DanilVDV/esp32-anenji-wifi-rs485-controller/docs/screenshots.md

# Актуальные скриншоты Web UI

Скриншоты сняты с текущего интерфейса прошивки v0.15.6 по записи экрана от 2026-10-08.

## Обзор / энергетическая схема

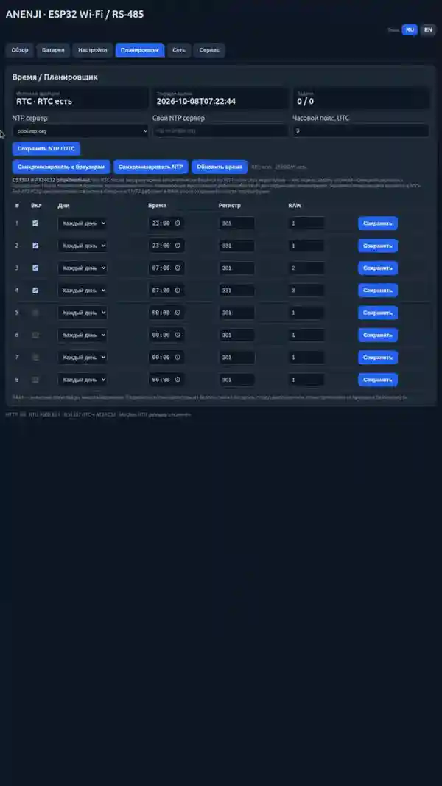
[picture p7: docs/media/dashboard.webp]
Обзор


## Статистика аккумулятора

Статистика аккумулятора

## Время / Планировщик

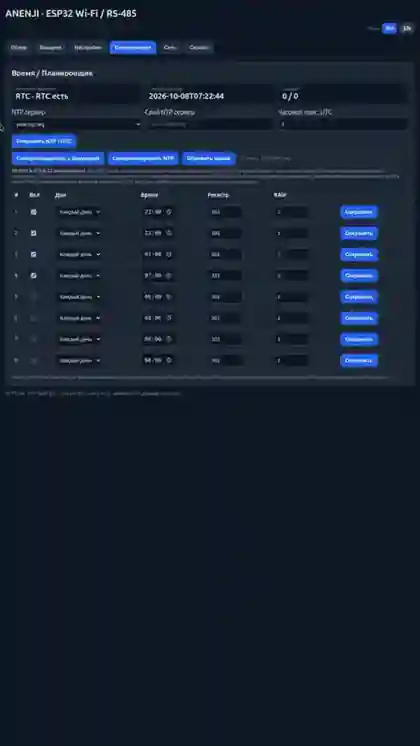
[picture p8: docs/media/rtc-scheduler.webp]
Время и планировщик


## Wi-Fi / сеть ESP32 и Modbus / RS-485

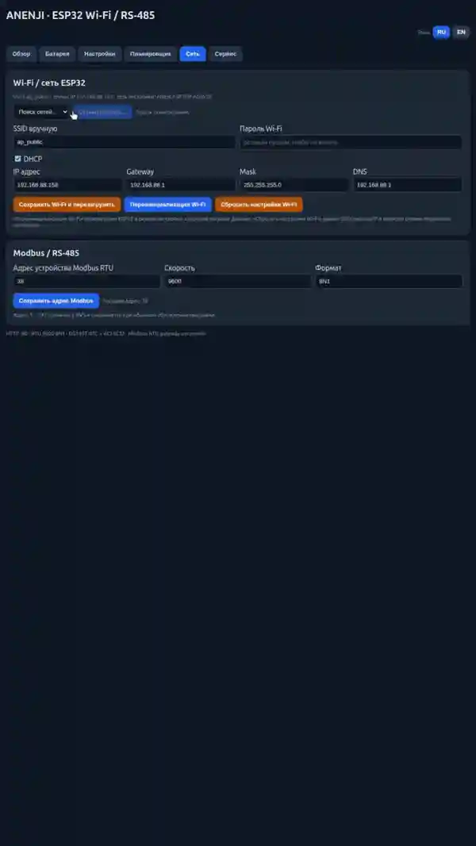
[picture p9: docs/media/network-modbus.webp]
Сеть и Modbus


## Сервис / PZEM-016 / OTA

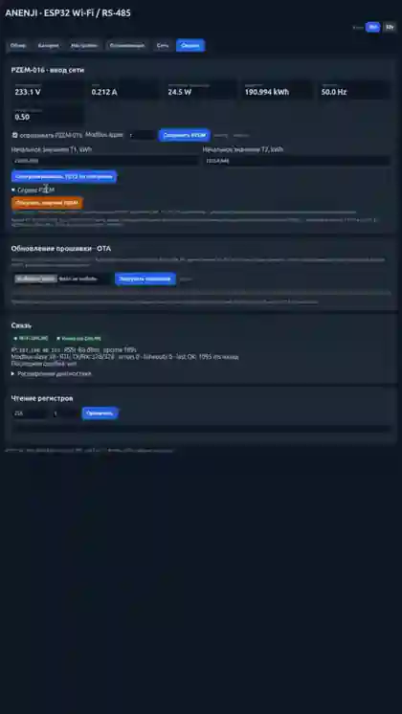
[picture p10: docs/media/service-pzem-ota.webp]
Сервис, PZEM и OTA
