DanilVDV/esp32-anenji-wifi-rs485-controller/docs/registers.md

# Modbus registers and battery profiles

Ниже перечислен allow-list из `SETTINGS[]`. `scale` означает делитель raw-значения для отображаемой величины там, где используется numeric setting.

| Reg | Group | Label | Type | Scale | Allowed |
|---:|---|---|---|---:|---|
| 300 | Основные | AC output mode | select | 1 | 0..4 |
| 301 | Основные | Приоритет выхода | select | 1 | 1..4 |
| 302 | Прочие | Диапазон входного напряжения | select | 1 | 0..2 |
| 303 | Прочие | Зуммер | select | 1 | 0..3 |
| 305 | Прочие | Подсветка LCD | select | 1 | 0..1 |
| 306 | Прочие | Автовозврат LCD | select | 1 | 0..1 |
| 307 | Прочие | Энергосбережение | select | 1 | 0..1 |
| 308 | Прочие | Автоперезапуск после перегрузки | select | 1 | 0..1 |
| 309 | Прочие | Автоперезапуск после перегрева | select | 1 | 0..1 |
| 310 | Прочие | Overload bypass | select | 1 | 0..1 |
| 313 | АКБ | Выравнивание АКБ | select | 1 | 0..1 |
| 320 | Основные | Выходное напряжение | select | 1 | 2200/2300/2400 |
| 321 | Основные | Выходная частота | select | 1 | 5000/6000 |
| 322 | АКБ | Тип АКБ | select | 1 | 0..2 |
| 323 | АКБ | Защита от перенапряжения АКБ | number | 10 | 0..6553.5 |
| 324 | АКБ | Bulk / CV | number | 10 | 0..6553.5 |
| 325 | АКБ | Float | number | 10 | 0..6553.5 |
| 326 | АКБ | Возврат к сети, напряжение | number | 10 | 0..6553.5 |
| 327 | АКБ | Low DC в режиме сети | number | 10 | 0..6553.5 |
| 329 | АКБ | Low DC off-grid | number | 10 | 0..6553.5 |
| 330 | АКБ | CV -> Float, время | number | 1 | 0..600 |
| 331 | АКБ | Приоритет зарядки | select | 1 | 1..4 |
| 332 | АКБ | Макс. ток зарядки | number | 10 | 0..6553.5 |
| 333 | АКБ | Макс. ток зарядки от сети | number | 10 | 0..6553.5 |
| 334 | АКБ | Напряжение equalization | number | 10 | 0..6553.5 |
| 335 | АКБ | Equalization time | number | 1 | 0..180 |
| 336 | АКБ | Equalization timeout | number | 1 | 0..300 |
| 337 | АКБ | Equalization interval | number | 1 | 1..90 |
| 341 | SOC | Low DC SOC в режиме сети | number | 1 | 0..100 |
| 342 | SOC | Recovery SOC | number | 1 | 0..100 |
| 343 | SOC | Off-grid cut-off SOC | number | 1 | 0..100 |
| 344 | Основные | Макс. отдача в сеть | number | 1 | 0..6200 |
| 351 | АКБ | Макс. ток разряда АКБ | number | 1 | 0..65535 |
| 406 | Remote | Turn-on mode | select | 1 | 0..2 |

## Профили

Raw values в точности из исходника.

### `ANJ_24V_8S_1P`

```text
313=0, 322=2, 332=150, 333=100,
324=280, 325=272, 327=232, 329=220,
341=20, 342=30, 343=15, 351=80
```

### `ANJ_24V_8S_2P`

```text
313=0, 322=2, 332=150, 333=100,
324=280, 325=272, 327=232, 329=220,
341=20, 342=30, 343=15, 351=120
```

### `ANJ_48V_STANDARD`

```text
313=0, 322=2, 332=100, 333=100,
324=564, 325=540, 327=460, 329=440,
341=20, 342=30, 343=15, 351=95
```

### `ANJ_48V_LONG_LIFE`

```text
313=0, 322=2, 332=100, 333=100,
324=560, 325=540, 327=460, 329=440,
341=20, 342=30, 343=15, 351=80
```

> Эти значения документируют поведение исходной прошивки, а не являются универсальной рекомендацией для любой LiFePO4-системы.
