DanilVDV/esp32-anenji-wifi-rs485-controller/docs/media/battery-stats.png

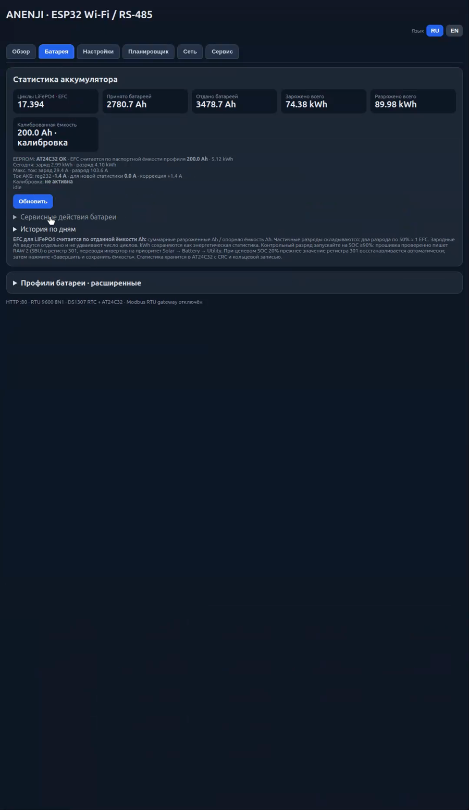
docs/media/battery-stats.png
