DanilVDV/esp32-anenji-wifi-rs485-controller/docs/media/dashboard.png

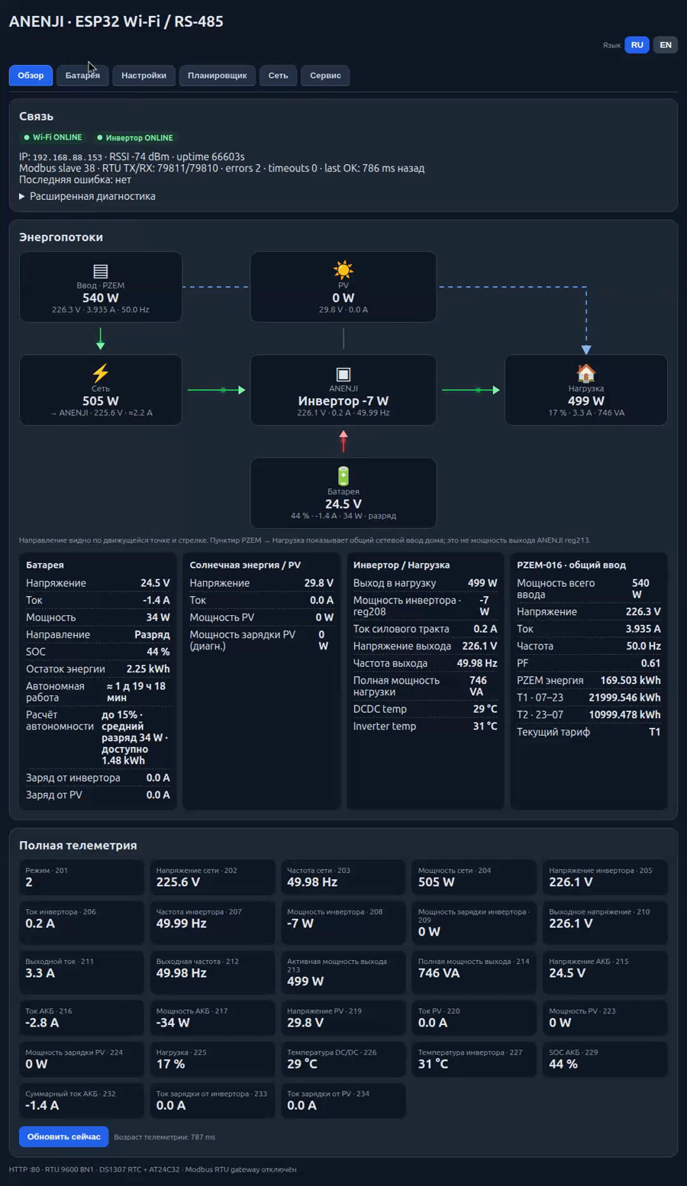
docs/media/dashboard.png
