DanilVDV/esp32-anenji-wifi-rs485-controller/docs/media/network-modbus.png

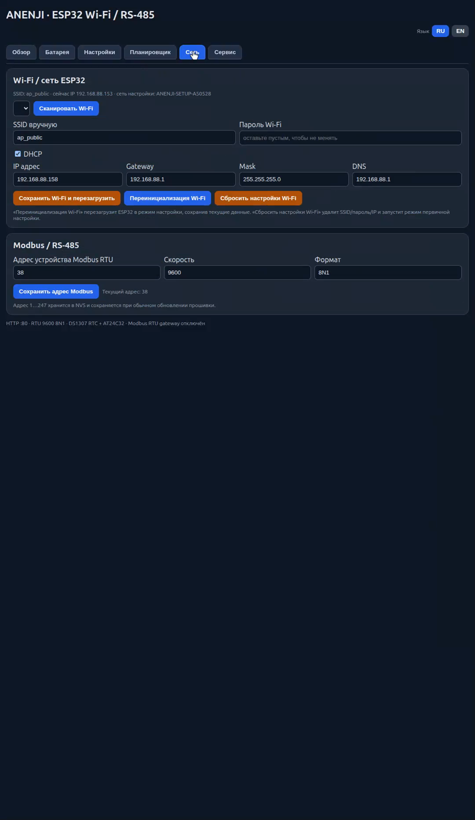
docs/media/network-modbus.png
