DanilVDV/esp32-anenji-wifi-rs485-controller/docs/media/rtc-scheduler.png

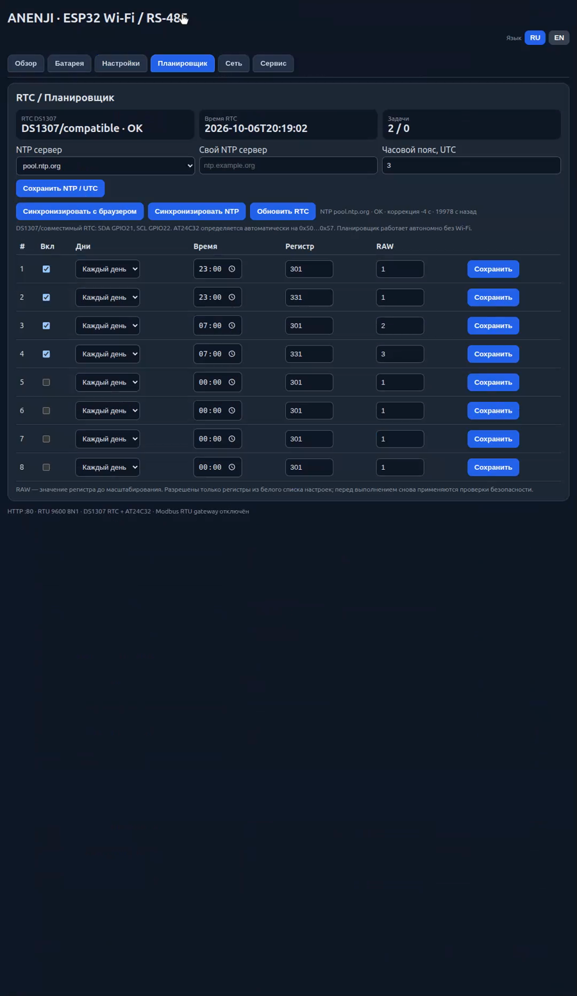
docs/media/rtc-scheduler.png
