DanilVDV/esp32-anenji-wifi-rs485-controller/docs/media/ui-v0157-service-2.png

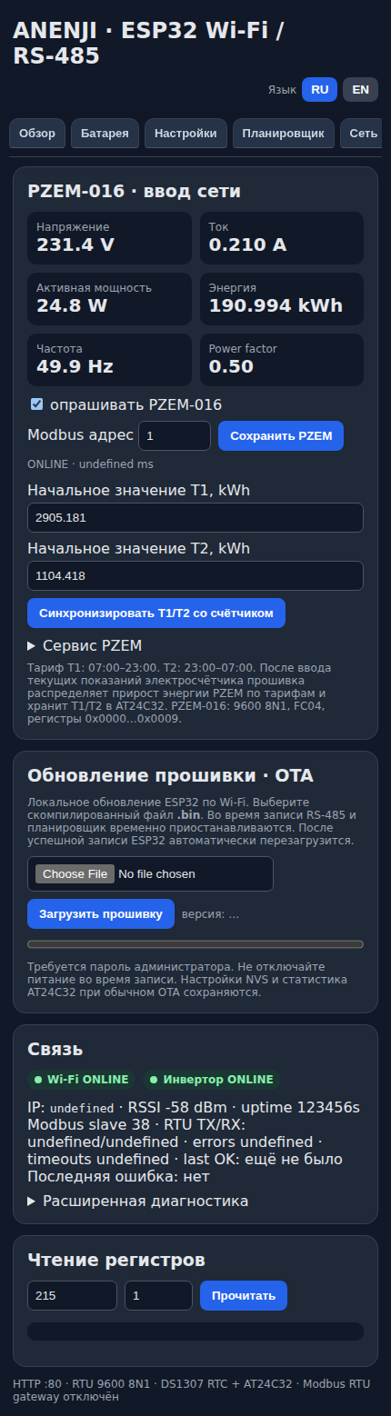
docs/media/ui-v0157-service-2.png
