DanilVDV/esp32-anenji-wifi-rs485-controller/docs/wiring.md

# Wiring / схема подключения

## 1. Подключение к ANENJI через RJ45 — порт RS‑485 (BMS)

Контроллер подключается к инвертору через разъём **RJ45** в гнездо **RS‑485 (BMS)**. Этот порт штатно предназначен для подключения BMS аккумуляторной батареи, однако доступный на нём Modbus RTU позволяет проекту не только читать телеметрию, но и записывать разрешённые параметры инвертора, применять профили и выполнять команды по расписанию.

По предоставленной таблице распиновки порта инвертора:

| Pin RJ45 | Цвет T568B | Сигнал |
|---:|---|---|
| 1 | бело‑оранжевый | **RS485-B** |
| 2 | оранжевый | **RS485-A** |
| 7 | бело‑коричневый | **RS485-A** |
| 8 | коричневый | **RS485-B** |
| 3–6 | остальные жилы | не используются |

Иными словами: **бело‑оранжевый = B, оранжевый = A, бело‑коричневый = A, коричневый = B**.

<p align="center">
  ANENJI RJ45 RS485 pinout
</p>

<p align="center">
  Connection to ANENJI RJ45 RS485 BMS
</p>

> Перед включением прозвоните кабель мультиметром. При взгляде на вилку с разных сторон нумерация RJ45 визуально зеркалится, поэтому ориентируйтесь на фактическую нумерацию контактов и цвета T568B.

## 2. ESP32 ↔ RS‑485 transceiver

Прошивка использует UART2 ESP32. На разных ESP32 DevKit одна и та же ножка может быть подписана как `4`, `IO4`, `D4` и т. п. **Главный ориентир — номер GPIO**; колонка ниже показывает распространённые варианты шелкографии.

| Сигнал | GPIO | Маркировка на ESP32 DevKit (типично) | Куда подключать |
|---|---:|---|---|
| RX2 | **16** | `RX2` / `IO16` / `16` / `D16` | `RO` RS‑485 transceiver |
| TX2 | **17** | `TX2` / `IO17` / `17` / `D17` | `DI` RS‑485 transceiver |
| Direction | **4** | `D4` / `IO4` / `4` | объединённые `DE` и `/RE` |
| 3.3 V | — | **`3V3` / `3.3V`** | `VCC` RS‑485 transceiver |
| GND | — | **`GND`** | общий GND |

Линии `A` и `B` трансивера идут на соответствующие линии RJ45 инвертора. PZEM‑016 может находиться на этой же half‑duplex шине.

```text
ESP32 DevKit                       RS-485 transceiver            RJ45 ANENJI RS-485 (BMS)
------------                       ------------------            ------------------------
GPIO17 / TX2 / IO17 -------------> DI
GPIO16 / RX2 / IO16 <------------- RO
GPIO4 / D4 / IO4 ----------------> DE + /RE
3V3 / 3.3V ----------------------> VCC
GND ------------------------------> GND
                                     A  --------------------------> A: pin 2 / pin 7
                                     B  --------------------------> B: pin 1 / pin 8
```

<p align="center">
  ESP32 DevKit pin labels used by ANENJI controller
</p>

Рекомендации для физического слоя:

- RS‑485-трансивер в этой сборке питается от **3.3 V (`3V3`)**; используйте модуль, рассчитанный на такое питание и логические уровни ESP32;
- общий GND обычно необходим, если нет гальванической развязки;
- используйте витую пару для A/B;
- терминация 120 Ω ставится по правилам конкретной RS‑485 топологии, обычно на концах длинной линии;
- если обмена нет, проверьте адрес Modbus и полярность A/B — маркировка A/B у разных производителей встречается инверсной.

## 3. I²C + ADS1115 + PZCT-DC63-300A

ESP32 использует `GPIO21`/`GPIO22` как общую I²C-шину. RTC и AT24C32 работают от 3.3 V. **ADS1115 и используемый PZCT-DC63-300A питаются от 5 V**, поэтому I²C-линии ADS1115 должны быть согласованы с 3.3-вольтовой логикой ESP32.

| Сигнал ESP32 | GPIO | Маркировка на ESP32 DevKit (типично) | Подключение |
|---|---:|---|---|
| SDA | **21** | `SDA` / `D21` / `IO21` / `21` | SDA RTC / AT24C32; к ADS1115 через I²C level shifter |
| SCL | **22** | `SCL` / `D22` / `IO22` / `22` | SCL RTC / AT24C32; к ADS1115 через I²C level shifter |
| 3.3 V | — | **`3V3` / `3.3V`** | VCC RTC / AT24C32 и LV level shifter |
| 5 V | — | **`5V` / `VIN`** | ADS1115 `VDD`, PZCT-DC63-300A `VCC`, HV level shifter |
| GND | — | **`GND`** | общий GND |

Типовой ADS1115 с выводами `VDD, SCL, SDA, ADDR, ALRT, A0…A3` подключается так:

| ADS1115 | Подключение |
|---|---|
| `VDD` | `5V / VIN` ESP32 |
| `GND` | общий GND |
| `SDA` | к GPIO21 через level shifter |
| `SCL` | к GPIO22 через level shifter |
| `ADDR` | к GND → адрес `0x48` |
| `ALRT` | не подключать |
| `A0` | `OUT` PZCT-DC63-300A |
| `A1…A3` | свободны / могут использоваться вместо A0 |

```text
ESP32 GPIO21 / SDA / D21 ----+---- DS1307/DS3231 SDA
                              +---- AT24C32 SDA
                              +---- LV1 [I2C level shifter] HV1 ---- ADS1115 SDA
ESP32 GPIO22 / SCL / D22 ----+---- DS1307/DS3231 SCL
                              +---- AT24C32 SCL
                              +---- LV2 [I2C level shifter] HV2 ---- ADS1115 SCL

ESP32 3V3 --------------------+---- RTC / AT24C32 VCC
                              +---- level shifter LV

ESP32 5V / VIN ---------------+---- ADS1115 VDD
                              +---- level shifter HV
                              +---- PZCT-DC63-300A VCC

ESP32 GND --------------------+---- ADS1115 GND
                              +---- PZCT-DC63-300A GND
                              +---- общий GND

PZCT-DC63-300A OUT -------------------------------> ADS1115 A0
ADS1115 ADDR --------------------------------------> GND   (0x48)
ADS1115 ALRT --------------------------------------> NC
```

> **Важно:** не допускайте подтяжки `SDA/SCL` ESP32 к 5 V. Если на модуле ADS1115 стоят встроенные pull-up к его VDD=5 V, используйте двунаправленный I²C level shifter. Альтернатива допустима только если 5-вольтовые pull-up физически отключены, а шина гарантированно подтянута к 3.3 V.

Параметры из кода:

- SDA = GPIO21;
- SCL = GPIO22;
- bus = 100 kHz;
- RTC = `0x68`;
- AT24C32 = scan `0x50..0x57`;
- ADS1115 = `0x48..0x4B`;
- I²C timeout = 50 ms.

Для используемого **PZCT-DC63-300A**:

- питание `+5 V DC ±5%`;
- номинал `±300 A`;
- измерительный диапазон `±330 A`;
- ноль около `2.5 V`;
- полный выход около `0.5…4.5 V`;
- номинальная чувствительность около `6.667 mV/A`.

Подробнее: [`hall-current-ads1115.md`](hall-current-ads1115.md).

## 4. BOOT

GPIO0 — штатная BOOT-кнопка многих ESP32 DevKit. На плате она может быть подписана `BOOT`, `IO0`, `0` или `D0`. Прошивка использует её также как сервисную кнопку:

- ~5 с → Setup AP;
- ~15 с → очистка Wi‑Fi config.

Учитывайте это при ручном входе в flashing mode.

## 5. Быстрая шпаргалка по надписям на ESP32 DevKit

| Функция в проекте | GPIO / питание | Что искать на плате |
|---|---:|---|
| RS‑485 RX | 16 | `RX2`, `IO16`, `16`, иногда `D16` |
| RS‑485 TX | 17 | `TX2`, `IO17`, `17`, иногда `D17` |
| RS‑485 DE+/RE | 4 | `D4`, `IO4`, `4` |
| I²C SDA | 21 | `SDA`, `D21`, `IO21`, `21` |
| I²C SCL | 22 | `SCL`, `D22`, `IO22`, `22` |
| BOOT | 0 | `BOOT`, `D0`, `IO0`, `0` |
| RTC / AT24C32 / RS‑485 питание | 3.3 V | `3V3`, `3.3V` |
| ADS1115 питание | 5 V | `5V`, `VIN` |
| PZCT-DC63-300A питание | 5 V | `5V`, `VIN` |
| Общий провод | — | `GND` |

> У разных DevKit подписи отличаются. Если на вашей плате нет `Dxx`, используйте число `GPIOxx`/`IOxx`: например, GPIO4 — это та же ножка, которую некоторые платы подписывают `D4`.
