DanilVDV/esp32-anenji-wifi-rs485-controller/firmware/ANENJI_ESP32_Controller/ANENJI_ESP32_Controller.ino

/*
  ESP32_ANENJI_WiFi_RS485_v0_14_12_eeprom_pzem_load_flow.ino

  Native ESP32 build for ANENJI ANJ-4000W-24V-WIFI.

  v0.14.24: OTA stabilization: keep RTU/system watchdog services paused through the post-upload reboot window.
  v0.14.15: compile fix: forward declaration for pzemTariffSave() before PZEM reset helper.
  v0.14.14: protected PZEM-016 accumulated-energy reset (0x42) via RTU worker; T1/T2 preserved.

  Features:
    - Wi-Fi STA only
    - HTTP Web UI on port 80
    - Periodic ANENJI telemetry
    - Settings read/write
    - Battery profiles 8S 1P / 8S 2P
    - Raw register explorer
    - No BMS polling
    - DS1307 RTC on I2C + persistent task scheduler
    - AT24C32 wear-levelled battery statistics, daily history and capacity calibration
    - No Ethernet

  Target: classic ESP32-WROOM-32 / "ESP32 Dev Module"

  RS-485:
    RO       -> GPIO16 (RX2)
    DI       -> GPIO17 (TX2)
    DE + /RE -> GPIO4
    GND      -> GND
    A/B      -> inverter RS-485

  NOTE:
    Web writes are enabled by ALLOW_WEB_WRITES below.
    HTTPS is intentionally not enabled in this v0.2 build: first verify
    native ESP32 reads/writes/profile/network configuration over the proven RS-485 link.
    Modbus RTU gateway is intentionally removed.
    v0.12.0: a single dedicated FreeRTOS RTU worker is the ONLY task allowed to touch UART2/RS-485.
    HTTP handlers only read RAM caches or enqueue work; telemetry, settings refresh, raw reads,
    manual writes, profiles and scheduler writes are serialized by that worker. This prevents
    slow/noisy Modbus transactions from blocking the synchronous WebServer loop.
*/

#include <WiFi.h>
#include <WebServer.h>
#include <Update.h>
#include <esp_ota_ops.h>
#include <Preferences.h>
#include <DNSServer.h>
#include <esp_system.h>
#include <esp_task_wdt.h>
#include <esp_timer.h>
#include <Wire.h>
#include <time.h>
#include <freertos/FreeRTOS.h>
#include <freertos/task.h>
#include <freertos/queue.h>

// ---------------- Arduino preprocessor-safe type declarations ----------------
enum SettingKind : uint8_t { SK_NUMBER, SK_SELECT };

struct SettingDef {
  uint16_t reg;
  const char* group;
  const char* label;
  SettingKind kind;
  float scale;
  float minVal;
  float maxVal;
  bool writable;
};

struct ProfileReg {
  uint16_t reg;
  uint16_t raw;
};

struct BatterySystemDetect {
  uint8_t systemV;       // 24, 48 or 0=unknown
  bool verified;         // independent clues agree
  float batteryV;
  float bulkV;
  float floatV;
  String reason;
};


struct RtcDateTime {
  uint16_t year;
  uint8_t month, day, hour, minute, second;
  bool valid;
};

struct ScheduleTask {
  bool enabled;
  uint8_t daysMask;   // bit0=Mon ... bit6=Sun
  uint8_t hour;
  uint8_t minute;
  uint16_t reg;
  uint16_t raw;
};

struct WebWriteJob {
  uint32_t id;
  uint16_t reg;
  uint16_t raw;
};

struct WebWriteResult {
  uint32_t id;
  bool done;
  bool ok;
  bool verified;
  uint16_t reg;
  uint16_t oldRaw;
  uint16_t newRaw;
  char error[120];
};

enum RtuJobType : uint8_t {
  RTU_JOB_WRITE = 1,
  RTU_JOB_RAW = 2,
  RTU_JOB_PROFILE = 3,
  RTU_JOB_SCHEDULE = 4,
  RTU_JOB_CAL_START = 5,
  RTU_JOB_CAL_RESTORE = 6,
  RTU_JOB_PZEM_RESET = 7
};

struct RtuJob {
  RtuJobType type;
  uint32_t id;
  uint16_t reg;
  uint16_t raw;
  uint16_t addr;
  uint16_t count;
  uint8_t profileId;
  uint8_t scheduleSlot;
};

struct RawReadResult {
  uint32_t id;
  bool done;
  bool ok;
  uint16_t addr;
  uint16_t count;
  uint16_t values[20];
  char error[120];
};

struct ProfileFailure {
  uint16_t reg;
  uint16_t raw;
  char error[80];
};

struct ProfileApplyResult {
  uint32_t id;
  bool done;
  bool ok;
  bool partial;
  uint16_t attempted;
  uint16_t applied;
  uint16_t failed;
  char profile[32];
  char error[200];
  ProfileFailure failures[16];
};

// ---------------- inverter faults / warnings / event log ----------------
struct InverterEvent {
  uint32_t id;
  uint32_t uptimeSec;
  char timestamp[20]; // YYYY-MM-DD HH:MM:SS, empty until logical clock is valid
  uint8_t type;      // 1=fault, 2=warning, 3=mode
  uint8_t bit;       // 0..31 for masks, 255 for mode
  uint8_t code;      // mode value for type=3
  bool active;
  char severity[10];
  char message[88];
};

const uint8_t INVERTER_EVENT_CAPACITY = 48;
InverterEvent inverterEvents[INVERTER_EVENT_CAPACITY] = {};
uint8_t inverterEventHead = 0;
uint8_t inverterEventCount = 0;
uint32_t inverterEventNextId = 1;
portMUX_TYPE inverterEventMux = portMUX_INITIALIZER_UNLOCKED;

static const char* const INVERTER_FAULTS[] = {
  "Inverter module over temperature", "DCDC module over temperature", "Battery over voltage",
  "PV module over temperature", "Output short circuit", "Inverter over voltage", "Output overload",
  "Bus over voltage", "Bus soft start timed out", "PV over current", "PV over voltage",
  "Battery over current", "Inverter over current", "Bus low voltage", "Reserved fault bit 14",
  "Inverter DC component too high", "Reserved fault bit 16", "Output current zero bias too large",
  "Inverter current zero bias too large", "Battery current zero bias too large",
  "PV current zero bias too large", "Inverter low voltage", "Inverter negative power protection",
  "Parallel host lost", "Parallel synchronization signal abnormal", "Battery type incompatible",
  "Parallel versions incompatible"
};
static const char* const INVERTER_WARNINGS[] = {
  "Mains supply zero-crossing loss", "Mains waveform abnormal", "Mains over voltage", "Mains low voltage",
  "Mains over frequency", "Mains low frequency", "PV low voltage", "Over temperature",
  "Battery low voltage", "Battery not connected", "Overload", "Battery equalization charging",
  "Battery undervoltage / recovery point not reached", "Output power derating", "Fan blocked", "PV energy too low to use",
  "Parallel communication interrupted", "Single/parallel output mode inconsistent",
  "Parallel battery voltage difference too large", "Lithium battery communication abnormal",
  "Battery discharge current exceeds configured limit"
};
const uint8_t INVERTER_FAULT_COUNT = sizeof(INVERTER_FAULTS)/sizeof(INVERTER_FAULTS[0]);
const uint8_t INVERTER_WARNING_COUNT = sizeof(INVERTER_WARNINGS)/sizeof(INVERTER_WARNINGS[0]);


#pragma pack(push,1)
// v2 layout is kept only for one-time migration from v0.12/v0.13.0.
struct BatteryStatsPersistV2 {
  uint32_t magic; uint16_t version; uint16_t size; uint32_t sequence;
  uint64_t charged_mWh; uint64_t discharged_mWh;
  uint32_t chargeSeconds; uint32_t dischargeSeconds;
  int32_t maxCharge_mA; int32_t maxDischarge_mA;
  uint32_t fullChargeEvents; uint32_t deepDischargeEvents;
  uint32_t calibratedEnergy_mWh; uint32_t dayDate;
  uint64_t dayStartCharged_mWh; uint64_t dayStartDischarged_mWh;
  uint32_t firstDate; uint32_t lastFullDate;
  uint8_t calibrationActive; uint8_t calibrationStartSoc; uint8_t calibrationEndSoc; uint8_t reserved0;
  int64_t calibrationNetDischarge_mWh; uint16_t crc;
};

// v3: LiFePO4 cycle count is based on discharged Ah throughput.
// Partial discharges accumulate: e.g. two 50% discharges ~= 1 EFC.
struct BatteryStatsPersist {
  uint32_t magic;
  uint16_t version;
  uint16_t size;
  uint32_t sequence;
  uint64_t charged_mWh;
  uint64_t discharged_mWh;
  uint64_t charged_mAh;
  uint64_t discharged_mAh;
  uint32_t chargeSeconds;
  uint32_t dischargeSeconds;
  int32_t maxCharge_mA;
  int32_t maxDischarge_mA;
  uint32_t calibratedEnergy_mWh;
  uint32_t dayDate;
  uint64_t dayStartCharged_mWh;
  uint64_t dayStartDischarged_mWh;
  uint64_t dayStartDischarged_mAh;
  uint32_t firstDate;
  uint8_t calibrationActive;
  uint8_t calibrationStartSoc;
  uint8_t calibrationEndSoc;
  uint8_t reserved0;
  int64_t calibrationNetDischarge_mWh;
  uint16_t crc;
};

struct BatteryDailyRecord {
  uint16_t magic;
  uint32_t date;
  uint32_t charged_mWh;
  uint32_t discharged_mWh;
  uint32_t discharged_mAh;
  uint32_t efc_milli;
  uint16_t crc;
};

// PZEM two-tariff virtual utility meter. Totals are stored as integer Wh.
struct PzemTariffPersist {
  uint32_t magic;
  uint16_t version;
  uint16_t size;
  uint32_t sequence;
  uint64_t t1_mWh;
  uint64_t t2_mWh;
  uint32_t pzemBaseline_Wh;
  uint8_t baselineValid;
  uint8_t reserved[17];
  uint16_t crc;
};
#pragma pack(pop)
static_assert(sizeof(BatteryStatsPersist) <= 112, "BatteryStatsPersist exceeds EEPROM slot");
static_assert(sizeof(BatteryStatsPersistV2) <= 112, "BatteryStatsPersistV2 exceeds EEPROM slot");
static_assert(sizeof(BatteryDailyRecord) <= 24, "BatteryDailyRecord exceeds EEPROM slot");
static_assert(sizeof(PzemTariffPersist) <= 64, "PzemTariffPersist exceeds EEPROM slot");

struct BatteryCalibrationState {
  bool active;
  bool targetReached;
  bool restoreQueued;
  bool outputRestored;
  uint8_t startSoc;
  uint8_t endSoc;
  int64_t netDischarge_mWh;
  uint64_t startCharged_mAh;
  uint64_t startDischarged_mAh;
  uint64_t startCharged_mWh;
  uint64_t startDischarged_mWh;
  uint16_t previousOutputPriority;
  bool previousOutputPriorityValid;
  uint32_t startedMs;
  char status[128];
};

// Explicit forward declarations for functions used before their definitions.
// This avoids Arduino auto-prototype ordering issues on ESP32 Arduino core 3.x.
void settingsCacheInvalidate();
int settingIndexByReg(uint16_t reg);
bool getCachedSettingRaw(uint16_t reg, uint16_t& raw);
void serviceBatteryStats();
void pzemTariffLoad();
void servicePzemTariff();
uint16_t crc16Data(const uint8_t* data, size_t len);
bool eepromReadBytes(uint16_t addr, uint8_t* dst, size_t len);
bool eepromWriteBytes(uint16_t addr, const uint8_t* src, size_t len);
void batteryStatsSave(bool force=false);
bool adminAuthorized();
bool haveReg(uint16_t reg);
void handleEvents();
bool i2cProbe(uint8_t addr);
void serviceHallCurrent();
void handleHallGet();
void handleHallConfigSet();
void handleHallZeroCal();
void handleHallSpanCal();


// ---------------- DEVICE / NETWORK SETTINGS ----------------
// Wi-Fi credentials are NOT stored in this sketch.
// They live in a dedicated NVS namespace "wifi_cfg".
//
// Provisioning:
//   - no saved Wi-Fi -> Setup AP automatically
//   - hold BOOT (GPIO0) ~5 s during boot -> Setup AP, saved Wi-Fi preserved
//   - hold BOOT ~15 s during boot -> erase Wi-Fi config only, then Setup AP
//
// Setup AP password is generated once and stored in "device_cfg".
// Normal firmware updates preserve NVS unless "Erase All Flash" is used.

const int BOOT_BUTTON_PIN = 0;
const uint32_t BOOT_SETUP_MS = 5000;
const uint32_t BOOT_WIFI_RESET_MS = 15000;

const bool ALLOW_WEB_WRITES = true;

Preferences wifiPrefs;
Preferences devicePrefs;
Preferences appPrefs;
Preferences schedPrefs;
DNSServer dnsServer;

String wifiSsid;
String wifiPass;
bool netUseStatic = false;
String netLocalIp = "192.168.88.158";
String netGateway = "192.168.88.1";
String netMask = "255.255.255.0";
String netDns = "192.168.88.1";

String setupApSsid;
String setupApPassword;
String adminPassword;
String activeProfile = "ANJ_24V_8S_1P";

bool setupMode = false;
bool setupRequestedByButton = false;
bool setupApRunning = false;
const IPAddress SETUP_AP_IP(192,168,4,1);
const IPAddress SETUP_AP_GW(192,168,4,1);
const IPAddress SETUP_AP_MASK(255,255,255,0);

// ANENJI / Modbus RTU
const uint8_t  DEFAULT_MODBUS_SLAVE = 1;
uint8_t modbusSlave = DEFAULT_MODBUS_SLAVE;
const uint32_t RS485_BAUD = 9600;
const uint32_t RTU_TIMEOUT_MS = 800;        // manual/API operations
const uint32_t RTU_POLL_TIMEOUT_MS = 260;   // background telemetry: fail fast
const uint32_t RTU_GAP_MS = 18;
const uint32_t POLL_INTERVAL_MS = 2000;
const uint32_t POLL_OFFLINE_INTERVAL_MS = 8000;

// Web writes use a bounded RTU time budget. Some ANENJI settings briefly pause
// Modbus while the inverter commits the new value.
const uint32_t RTU_WRITE_TIMEOUT_MS = 650;
const uint32_t RTU_VERIFY_TIMEOUT_MS = 350;
const uint32_t POST_WRITE_QUIET_MS = 1800;
uint32_t rtuQuietUntilMs = 0;

// One RTU worker owns UART2. Every Modbus operation is serialized through this queue.
QueueHandle_t rtuJobQueue = nullptr;
TaskHandle_t rtuWorkerHandle = nullptr;
volatile bool rtuWorkerBusy = false;
volatile bool webWriteBusReserved = false; // true only while a write/profile/scheduler write is executing
volatile bool telemetryForceRequested = false;
volatile bool settingsRefreshRequested = false;
volatile bool settingsRefreshBusy = false;
volatile uint32_t settingsRefreshGeneration = 0;
volatile uint32_t rtuNextJobId = 1;
volatile uint32_t rtuWorkerHeartbeat = 0;
volatile uint32_t rtuWorkerLastMs = 0;

WebWriteResult webWriteResult = {0,false,false,false,0,0,0,{0}};
portMUX_TYPE webWriteResultMux = portMUX_INITIALIZER_UNLOCKED;
RawReadResult rawReadResult = {0,false,false,0,0,{0},{0}};
portMUX_TYPE rawReadResultMux = portMUX_INITIALIZER_UNLOCKED;
ProfileApplyResult profileApplyResult = {};
portMUX_TYPE profileApplyResultMux = portMUX_INITIALIZER_UNLOCKED;

// ---------------- watchdog / self-recovery ----------------
// Hardware Task WDT catches a genuinely stuck Arduino loop.
// Other watchdogs perform controlled recovery before a hard reboot is needed.
const uint32_t TASK_WDT_TIMEOUT_MS = 12000;
const uint8_t  RTU_RECOVERY_AFTER_FAILED_POLLS = 3;
const uint32_t WIFI_WATCHDOG_REBOOT_MS = 15UL * 60UL * 1000UL;
const uint8_t  WIFI_WATCHDOG_MAX_REBOOTS = 3;
const uint32_t LOW_HEAP_LIMIT_BYTES = 20000;
const uint32_t LOW_HEAP_HOLD_MS = 30000;

// RTU self-recovery watchdogs. The Arduino loop WDT cannot detect a dead/stuck
// dedicated RTU task, so monitor its heartbeat separately.
const uint32_t RTU_WORKER_STALL_MS = 15000;
const uint32_t RTU_OFFLINE_RESTART_MS = 90000; // restart ESP only if inverter had been online before
const uint32_t RTU_UART_RECOVERY_MIN_INTERVAL_MS = 5000;

// ESP32 pins
const int RS485_RX_PIN = 16;
const int RS485_TX_PIN = 17;
const int RS485_DE_RE_PIN = 4;

// RTC + external I2C EEPROM. The photographed module uses DS1307 + AT24C32.
// DS1307 and DS3231 share the same basic time-register layout at 0x68, so the
// time driver intentionally uses the common subset. DS1307 CH (seconds bit 7)
// is handled explicitly.
const int RTC_SDA_PIN = 21;
const int RTC_SCL_PIN = 22;
const uint8_t RTC_I2C_ADDR = 0x68;
const uint8_t AT24C32_ADDR_FIRST = 0x50;
const uint8_t AT24C32_ADDR_LAST  = 0x57;
const uint16_t AT24C32_SIZE = 4096;
const uint8_t AT24C32_PAGE_SIZE = 32;
const uint8_t SCHEDULE_TASK_COUNT = 8;
ScheduleTask scheduleTasks[SCHEDULE_TASK_COUNT] = {};
bool rtcPresent = false;
enum ClockSource : uint8_t { CLOCK_NONE=0, CLOCK_RTC=1, CLOCK_NTP=2, CLOCK_BROWSER=3 };
ClockSource clockSource = CLOCK_NONE;
uint64_t clockCachedAtUs = 0;
bool clockNow(RtcDateTime& out);
const char* clockSourceName();

// NTP -> local software clock, with optional DS1307 persistence. NTP is UTC; local RTC is kept in local civil time.
const char* NTP_DEFAULT_SERVER = "pool.ntp.org";
const char* NTP_FALLBACK_SERVER = "time.google.com";
String ntpServer = NTP_DEFAULT_SERVER;
int16_t ntpUtcOffsetMin = 180; // fixed UTC offset, default UTC+03:00
const uint32_t NTP_INITIAL_RETRY_MS = 5000UL;
const uint32_t NTP_RETRY_MS = 15UL*60UL*1000UL;
const uint32_t NTP_RESYNC_MS = 6UL*60UL*60UL*1000UL;
bool ntpConfigured=false;
bool ntpEverSynced=false;
uint32_t ntpLastAttemptMs=0;
uint32_t ntpLastSyncMs=0;
int32_t ntpLastCorrectionSec=0;
uint32_t schedulerRuns = 0;
uint32_t schedulerErrors = 0;
String schedulerLast;
uint32_t schedulerLastMinuteKey = 0xFFFFFFFFUL;
RtcDateTime rtcCached = {0,0,0,0,0,0,false};
uint32_t rtcCachedAtMs = 0;


// ---------------- battery statistics / AT24C32 ----------------
const uint32_t BAT_STATS_MAGIC = 0x42535431UL; // "BST1"
const uint16_t BAT_STATS_VERSION = 3;
const uint16_t BAT_DAILY_MAGIC = 0xDA18;
const uint16_t BAT_STATS_SLOT_SIZE = 112;
const uint8_t BAT_STATS_SLOT_COUNT = 24; // 2688 bytes
const uint16_t BAT_DAILY_BASE = BAT_STATS_SLOT_SIZE * BAT_STATS_SLOT_COUNT;
const uint16_t BAT_DAILY_SLOT_SIZE = 24;
const uint8_t BAT_DAILY_SLOT_COUNT = 32;
const uint32_t BAT_STATS_SAVE_INTERVAL_MS = 5UL * 60UL * 1000UL;
const uint32_t BAT_STATS_DIRTY_ENERGY_MWH = 50000UL; // 50 Wh
const float BAT_CURRENT_DEADBAND_A = 0.20f;
// ANENJI reg232 shows about -1.4 A around true battery zero current on this installation.
// Correct only the current used for NEW battery statistics; persisted totals/EFC are never rewritten.
const float BAT_STATS_CURRENT_OFFSET_A = 1.40f;
float batteryStatsRawCurrentA = NAN;
float batteryStatsCountedCurrentA = NAN;

// AT24C32 bytes 0..3455 are used by battery stats/history. Reserve 512 bytes
// at the end for 8 wear-levelled tariff slots.
const uint32_t PZEM_TARIFF_MAGIC = 0x505A5431UL; // PZT1
const uint16_t PZEM_TARIFF_VERSION = 1;
const uint16_t PZEM_TARIFF_BASE = 3456;
const uint16_t PZEM_TARIFF_SLOT_SIZE = 64;
const uint8_t PZEM_TARIFF_SLOT_COUNT = 8;
const uint32_t PZEM_TARIFF_SAVE_INTERVAL_MS = 5UL*60UL*1000UL;
const uint32_t PZEM_TARIFF_DIRTY_MWH = 10000UL; // legacy/diagnostic only; normal saves are time-limited

bool eepromPresent = false;
uint8_t eepromI2cAddr = 0;
BatteryStatsPersist batteryStats = {};
BatteryCalibrationState batteryCalibration = {};
uint8_t batteryStatsSlot = 0;
uint8_t batteryDailySlot = 0;
bool batteryStatsDirty = false;
uint64_t batteryLastSavedCharged_mWh = 0;
uint64_t batteryLastSavedDischarged_mWh = 0;
uint32_t batteryStatsLastSaveMs = 0;
uint32_t batteryStatsLastTelemetryStamp = 0;
double batteryChargeFrac_mWh = 0.0;
double batteryDischargeFrac_mWh = 0.0;
double batteryChargeFrac_mAh = 0.0;
double batteryDischargeFrac_mAh = 0.0;

HardwareSerial RS485(2);
WebServer web(80);


const char* FW_VERSION = "0.15.10";
const char* FW_VERSION_PREVIOUS = "0.15.9";

// Web OTA state. During flash writes the RTU worker and scheduler are paused.
volatile bool otaInProgress=false;
bool otaUploadAuthorized=false;
bool otaUploadOk=false;
bool otaRestartPending=false;
uint32_t otaRestartAtMs=0;
String otaUploadError;
size_t otaBytesWritten=0;
size_t otaPartitionSize=0;
int otaUpdateError=0;
bool otaHeaderChecked=false;
volatile bool otaUploadUnlocked=false;
uint32_t otaUploadUnlockUntilMs=0;

// ---------------- diagnostics / cache ----------------
uint32_t rtuTx = 0;
uint32_t rtuRx = 0;
uint32_t rtuErrors = 0;
uint32_t rtuTimeouts = 0;
uint32_t webWrites = 0;
uint32_t webWriteErrors = 0;
String lastError; // RTU-worker private
char lastErrorPublic[128] = {0};
uint32_t lastOkMs = 0;

uint16_t telemetryRaw[40] = {0};   // 200..239
bool telemetryValid[40] = {false};
uint32_t telemetryUpdatedMs = 0;
uint32_t lastPollMs = 0;

uint16_t inverterDiagRaw[10] = {0}; // 100..109
bool inverterDiagValid = false;
uint32_t inverterDiagUpdatedMs = 0;
uint32_t inverterFaultMask = 0;
uint32_t inverterWarningMask = 0;
uint32_t inverterWarningUnmaskedMask = 0;
uint32_t inverterPrevFaultMask = 0;
uint32_t inverterPrevWarningMask = 0;
bool inverterMasksInitialized = false;
uint8_t inverterPrevMode = 0;
bool inverterPrevModeValid = false;

// PZEM-016 on the same RS-485 bus as ANENJI. Default PZEM address is 1;
// ANENJI currently uses its own configurable address (38 in the present installation).
const uint8_t PZEM_DEFAULT_SLAVE = 1;
uint8_t pzemSlave = PZEM_DEFAULT_SLAVE;
bool pzemEnabled = true;
bool pzemOnline = false;
float pzemVoltage=NAN, pzemCurrent=NAN, pzemPower=NAN, pzemEnergyKwh=NAN, pzemFrequency=NAN, pzemPf=NAN;
bool pzemAlarm=false;
uint32_t pzemUpdatedMs=0, pzemLastPollMs=0, pzemPollOk=0, pzemPollErrors=0;

// Optional PZCT-DC63 Hall DC current sensor via ADS1115 on the shared I2C bus.
// Address 0 means auto-detect 0x48..0x4B. Default calibration matches the
// common 100 A version: about 2.5 V at zero and about 20 mV/A.
const uint8_t ADS1115_ADDR_FIRST=0x48;
const uint8_t ADS1115_ADDR_LAST=0x4B;
bool hallEnabled=false;
bool hallOnline=false;
uint8_t hallAdsAddress=0;
uint8_t hallResolvedAddress=0;
uint8_t hallChannel=0;
float hallZeroMv=2500.0f;
float hallSensitivityMvPerA=20.0f;
bool hallInvert=false;
float hallInputMv=NAN;
float hallCurrentA=NAN;
uint32_t hallUpdatedMs=0;
uint32_t hallLastPollMs=0;
const uint32_t HALL_POLL_INTERVAL_MS=1000;
// PZEM-016 is an energy meter, so a slow poll is preferable to competing with
// the inverter for the shared half-duplex RS-485 bus.
const uint32_t PZEM_POLL_INTERVAL_MS = 5000;
const uint32_t PZEM_RTU_TIMEOUT_MS = 700;
const uint32_t PZEM_BUS_GUARD_BEFORE_MS = 90;
const uint32_t PZEM_BUS_GUARD_AFTER_MS = 70;
PzemTariffPersist pzemTariff = {};
uint8_t pzemTariffSlot = 0;
bool pzemTariffDirty = false;
uint32_t pzemTariffLastSaveMs = 0;
uint64_t pzemTariffLastSavedTotal_mWh = 0;
uint8_t pzemTariffLastTariff = 0; // detect 07:00/23:00 boundary for forced persistence

bool taskWdtEnabled = false;
TaskHandle_t mainLoopTaskHandle = nullptr;
uint32_t rtuConsecutivePollFailures = 0;
uint32_t rtuUartRecoveries = 0;
uint32_t rtuLastUartRecoveryMs = 0;
bool inverterEverOnline = false;
uint32_t inverterOfflineSinceMs = 0;
RTC_DATA_ATTR uint8_t rtuControlledReboots = 0;
uint32_t rtuWorkerStallEvents = 0;
uint32_t wifiDisconnectedSinceMs = 0;
uint32_t lowHeapSinceMs = 0;
uint32_t lowHeapEvents = 0;
uint32_t loopHeartbeat = 0;
RTC_DATA_ATTR uint8_t wifiWatchdogReboots = 0;

// ---------------- watchdog helpers ----------------
const char* resetReasonText(esp_reset_reason_t r) {
  switch (r) {
    case ESP_RST_POWERON:   return "POWERON";
    case ESP_RST_EXT:       return "EXTERNAL";
    case ESP_RST_SW:        return "SOFTWARE";
    case ESP_RST_PANIC:     return "PANIC";
    case ESP_RST_INT_WDT:   return "INT_WDT";
    case ESP_RST_TASK_WDT:  return "TASK_WDT";
    case ESP_RST_WDT:       return "WDT";
    case ESP_RST_DEEPSLEEP: return "DEEPSLEEP";
    case ESP_RST_BROWNOUT:  return "BROWNOUT";
    case ESP_RST_SDIO:      return "SDIO";
    default:                return "UNKNOWN";
  }
}

void initTaskWatchdog() {
  // Arduino-ESP32 core 3.x normally initializes TWDT before setup().
  // First try to subscribe the Arduino loop task to the existing watchdog.
  // Only initialize TWDT ourselves when the core reports that it is not initialized.
  esp_err_t e = esp_task_wdt_add(NULL);
  if (e == ESP_ERR_INVALID_STATE) {
    esp_task_wdt_config_t cfg = {};
    cfg.timeout_ms = TASK_WDT_TIMEOUT_MS;
    cfg.idle_core_mask = (1U << portNUM_PROCESSORS) - 1U;
    cfg.trigger_panic = true;
    esp_err_t initErr = esp_task_wdt_init(&cfg);
    if (initErr == ESP_OK) e = esp_task_wdt_add(NULL);
    else e = initErr;
  } else if (e == ESP_ERR_INVALID_ARG) {
    // Some core/IDF combinations return INVALID_ARG when the task is already subscribed.
    // The status call below is authoritative.
  }

  taskWdtEnabled = (esp_task_wdt_status(NULL) == ESP_OK);
  Serial.print(F("[WDT] Task watchdog: "));
  Serial.println(taskWdtEnabled ? F("enabled") : F("not available"));
}

inline void feedTaskWatchdog() {
  if (!taskWdtEnabled) return;
  // Only the Arduino loop task is subscribed to TWDT. RTU helpers are also used
  // by the asynchronous write worker; calling esp_task_wdt_reset() from that
  // unsubscribed task produces "task not found" spam on ESP32 Arduino core 3.x.
  if (mainLoopTaskHandle && xTaskGetCurrentTaskHandle() != mainLoopTaskHandle) return;
  esp_task_wdt_reset();
}

void recoverRs485Uart() {
  uint32_t now = millis();
  if (rtuLastUartRecoveryMs && (uint32_t)(now - rtuLastUartRecoveryMs) < RTU_UART_RECOVERY_MIN_INTERVAL_MS) return;
  rtuLastUartRecoveryMs = now;
  Serial.println(F("[WDT] RTU recovery: restarting UART2 / forcing receive mode"));
  // Force the transceiver back to RX first. This is useful after inverter mode/bypass
  // transitions where the serial side can leave stale bytes or the direction line
  // in an unfortunate state.
  pinMode(RS485_DE_RE_PIN, OUTPUT);
  rs485ReceiveMode();
  delay(20);
  clearRs485Input();
  RS485.end();
  delay(80);
  rs485ReceiveMode();
  RS485.begin(RS485_BAUD, SERIAL_8N1, RS485_RX_PIN, RS485_TX_PIN);
  delay(30);
  clearRs485Input();
  rtuUartRecoveries++;
  rtuConsecutivePollFailures = 0;
}

void serviceRtuWatchdog() {
  // Never run UART recovery/reboot logic while the synchronous OTA HTTP request owns loopTask.
  if (otaInProgress || otaRestartPending) return;
  if (setupMode || !rtuWorkerHandle) return;
  const uint32_t now = millis();

  // A separate heartbeat is required because only the Arduino loop task is
  // subscribed to TWDT. If the RTU task wedges, HTTP may remain alive forever.
  if (rtuWorkerLastMs && (uint32_t)(now - rtuWorkerLastMs) > RTU_WORKER_STALL_MS) {
    rtuWorkerStallEvents++;
    Serial.print(F("[WDT] RTU worker heartbeat stalled for ms="));
    Serial.println((uint32_t)(now - rtuWorkerLastMs));
    Serial.println(F("[WDT] controlled ESP restart to recover RTU worker"));
    delay(50);
    ESP.restart();
  }

  const bool online = inverterOnline();
  if (online) {
    inverterEverOnline = true;
    inverterOfflineSinceMs = 0;
    rtuControlledReboots = 0;
    return;
  }

  if (!inverterEverOnline) return; // don't reboot forever when inverter is physically absent
  if (!inverterOfflineSinceMs) inverterOfflineSinceMs = now;

  // Re-sync UART periodically while the inverter is offline. PollTelemetry already
  // does this after failed polls; this timer is an independent safety net.
  if (!rtuWorkerBusy && !webWriteBusReserved &&
      (!rtuLastUartRecoveryMs || (uint32_t)(now - rtuLastUartRecoveryMs) >= 30000UL)) {
    recoverRs485Uart();
    telemetryForceRequested = true;
  }

  // If communication was healthy earlier and never comes back after a mode/bypass
  // event, one controlled reboot is preferable to staying offline indefinitely.
  // After reboot, a physically disconnected inverter will never set inverterEverOnline,
  // so this does not create an endless reboot loop.
  if ((uint32_t)(now - inverterOfflineSinceMs) >= RTU_OFFLINE_RESTART_MS &&
      rtuControlledReboots < 1) {
    rtuControlledReboots++;
    Serial.println(F("[WDT] inverter RTU offline >90 s after prior online state; restarting ESP"));
    delay(50);
    ESP.restart();
  }
}

void serviceHeapWatchdog() {
  uint32_t freeHeap = ESP.getFreeHeap();
  if (freeHeap < LOW_HEAP_LIMIT_BYTES) {
    if (!lowHeapSinceMs) {
      lowHeapSinceMs = millis();
      lowHeapEvents++;
      Serial.print(F("[WDT] low heap: "));
      Serial.println(freeHeap);
    } else if ((uint32_t)(millis() - lowHeapSinceMs) >= LOW_HEAP_HOLD_MS) {
      Serial.println(F("[WDT] low heap persisted; restarting"));
      delay(50);
      ESP.restart();
    }
  } else {
    lowHeapSinceMs = 0;
  }
}

void serviceWifiWatchdog() {
  if (setupMode || wifiSsid.length() == 0) {
    wifiDisconnectedSinceMs = 0;
    return;
  }

  if (WiFi.status() == WL_CONNECTED) {
    wifiDisconnectedSinceMs = 0;
    wifiWatchdogReboots = 0;
    return;
  }

  if (!wifiDisconnectedSinceMs) wifiDisconnectedSinceMs = millis();

  if ((uint32_t)(millis() - wifiDisconnectedSinceMs) >= WIFI_WATCHDOG_REBOOT_MS &&
      wifiWatchdogReboots < WIFI_WATCHDOG_MAX_REBOOTS) {
    wifiWatchdogReboots++;
    Serial.print(F("[WDT] Wi-Fi offline too long; controlled reboot "));
    Serial.println(wifiWatchdogReboots);
    delay(50);
    ESP.restart();
  }
}

// ---------------- helpers ----------------
uint16_t crc16Modbus(const uint8_t* data, size_t len) {
  uint16_t crc = 0xFFFF;
  for (size_t i = 0; i < len; ++i) {
    crc ^= data[i];
    for (uint8_t b = 0; b < 8; ++b) {
      crc = (crc & 1) ? (crc >> 1) ^ 0xA001 : (crc >> 1);
    }
  }
  return crc;
}

int16_t asS16(uint16_t v) { return (int16_t)v; }

String jsonEscape(const String& s) {
  String r;
  r.reserve(s.length() + 8);
  for (size_t i = 0; i < s.length(); ++i) {
    char c = s[i];
    if (c == '"' || c == '\\') { r += '\\'; r += c; }
    else if (c == '\n') r += F("\\n");
    else if ((uint8_t)c >= 0x20) r += c;
  }
  return r;
}

String jsonNum(float v, uint8_t decimals = 1) {
  if (isnan(v)) return F("null");
  return String(v, (unsigned int)decimals);
}

void syncLastErrorPublic() {
  size_t n=lastError.length(); if(n>=sizeof(lastErrorPublic))n=sizeof(lastErrorPublic)-1;
  memcpy(lastErrorPublic,lastError.c_str(),n); lastErrorPublic[n]=0;
}

void sendJson(int code, const String& body) {
  web.send(code, "application/json; charset=utf-8", body);
}

void rs485ReceiveMode() {
  digitalWrite(RS485_DE_RE_PIN, LOW);
}

void rs485TransmitMode() {
  digitalWrite(RS485_DE_RE_PIN, HIGH);
  delayMicroseconds(60);
}

void clearRs485Input() {
  while (RS485.available()) RS485.read();
}

// ---------------- RTU ----------------
bool rtuExchange(const uint8_t* req, size_t reqLen,
                 uint8_t* resp, size_t respMax, size_t& respLen,
                 uint32_t timeoutMs = RTU_TIMEOUT_MS) {
  // v0.11.0 invariant: UART2/RS-485 may only be touched by the dedicated RTU worker.
  // This guard catches accidental future calls from HTTP/loop code instead of allowing collisions.
  if (rtuWorkerHandle && xTaskGetCurrentTaskHandle() != rtuWorkerHandle) {
    lastError = F("RTU access outside worker blocked");
    respLen = 0;
    return false;
  }
  respLen = 0;
  clearRs485Input();

  rs485TransmitMode();
  RS485.write(req, reqLen);
  RS485.flush();
  delayMicroseconds(150);
  rs485ReceiveMode();
  rtuTx++;

  uint32_t start = millis();
  uint32_t lastByte = start;
  bool gotAny = false;
  rtuWorkerLastMs = start;

  while ((uint32_t)(millis() - start) < timeoutMs) {
    rtuWorkerLastMs = millis();
    while (RS485.available()) {
      int c = RS485.read();
      if (c >= 0) {
        gotAny = true;
        lastByte = millis();
        if (respLen < respMax) resp[respLen++] = (uint8_t)c;
        else {
          lastError = F("RTU response too long");
          rtuErrors++;
          return false;
        }
      }
    }
    if (gotAny && (uint32_t)(millis() - lastByte) >= RTU_GAP_MS) break;
    feedTaskWatchdog();
    delay(1);
  }

  if (!gotAny) {
    rtuTimeouts++;
    rtuErrors++;
    lastError = F("RTU timeout");
    return false;
  }
  if (respLen < 5) {
    rtuErrors++;
    lastError = F("Short RTU response");
    return false;
  }

  uint16_t gotCrc = (uint16_t)resp[respLen - 2] | ((uint16_t)resp[respLen - 1] << 8);
  uint16_t calcCrc = crc16Modbus(resp, respLen - 2);
  if (gotCrc != calcCrc) {
    rtuErrors++;
    lastError = F("RTU CRC error");
    return false;
  }
  if (resp[0] != req[0]) {
    rtuErrors++;
    lastError = F("Unexpected RTU slave");
    return false;
  }

  rtuRx++;
  lastOkMs = millis();
  lastError = "";
  return true;
}

bool readHoldingUnit(uint8_t slave, uint16_t addr, uint16_t qty, uint16_t* out,
                     uint32_t timeoutMs = RTU_TIMEOUT_MS) {
  if (!qty || qty > 40) return false;

  uint8_t req[8];
  req[0] = slave;
  req[1] = 0x03;
  req[2] = addr >> 8;
  req[3] = addr & 0xFF;
  req[4] = qty >> 8;
  req[5] = qty & 0xFF;
  uint16_t crc = crc16Modbus(req, 6);
  req[6] = crc & 0xFF;
  req[7] = crc >> 8;

  uint8_t resp[128];
  size_t n = 0;
  if (!rtuExchange(req, sizeof(req), resp, sizeof(resp), n, timeoutMs)) return false;
  if (resp[1] & 0x80) {
    lastError = String("Modbus exception 0x") + String(resp[2], HEX);
    rtuErrors++;
    return false;
  }
  if (resp[1] != 0x03 || resp[2] != qty * 2 || n != (size_t)(5 + qty * 2)) {
    lastError = F("Unexpected FC03 response");
    rtuErrors++;
    return false;
  }

  for (uint16_t i = 0; i < qty; ++i) {
    out[i] = ((uint16_t)resp[3 + i * 2] << 8) | resp[4 + i * 2];
  }
  return true;
}

bool readHolding(uint16_t addr, uint16_t qty, uint16_t* out,
                 uint32_t timeoutMs = RTU_TIMEOUT_MS) {
  return readHoldingUnit(modbusSlave, addr, qty, out, timeoutMs);
}

// FC16, one register, same method used by the Python gateway build.
// Dedicated timeout prevents a web write from holding the synchronous HTTP server indefinitely.
bool writeHoldingSingle(uint16_t addr, uint16_t value, uint32_t timeoutMs = RTU_WRITE_TIMEOUT_MS) {
  uint8_t req[11];
  req[0] = modbusSlave;
  req[1] = 0x10;
  req[2] = addr >> 8;
  req[3] = addr & 0xFF;
  req[4] = 0;
  req[5] = 1;
  req[6] = 2;
  req[7] = value >> 8;
  req[8] = value & 0xFF;
  uint16_t crc = crc16Modbus(req, 9);
  req[9] = crc & 0xFF;
  req[10] = crc >> 8;

  uint8_t resp[32];
  size_t n = 0;
  if (!rtuExchange(req, sizeof(req), resp, sizeof(resp), n, timeoutMs)) return false;
  if (resp[1] & 0x80) {
    lastError = String("Write exception 0x") + String(resp[2], HEX);
    rtuErrors++;
    return false;
  }
  if (n != 8 || resp[1] != 0x10 ||
      resp[2] != req[2] || resp[3] != req[3] ||
      resp[4] != 0 || resp[5] != 1) {
    lastError = F("Unexpected FC16 write response");
    rtuErrors++;
    return false;
  }
  return true;
}

bool writeAndVerify(uint16_t addr, uint16_t raw, uint16_t& oldRaw, uint16_t& newRaw) {
  uint16_t v = 0;
  if (!readHolding(addr, 1, &v, RTU_WRITE_TIMEOUT_MS)) return false;
  oldRaw = v;
  newRaw = oldRaw;

  if (oldRaw == raw) return true;

  if (!writeHoldingSingle(addr, raw, RTU_WRITE_TIMEOUT_MS)) return false;

  // FC16 ACK means the request was accepted. The inverter may pause Modbus briefly
  // while saving a setting, so confirm with several short bounded read-backs.
  const uint16_t verifyPauseMs[] = {150, 300, 500, 700};
  bool gotReadback = false;
  for (size_t attempt = 0; attempt < sizeof(verifyPauseMs)/sizeof(verifyPauseMs[0]); ++attempt) {
    rtuWorkerLastMs = millis();
    delay(verifyPauseMs[attempt]);
    rtuWorkerLastMs = millis();
    feedTaskWatchdog();
    if (readHolding(addr, 1, &v, RTU_VERIFY_TIMEOUT_MS)) {
      gotReadback = true;
      newRaw = v;
      if (newRaw == raw) {
        webWrites++;
        rtuQuietUntilMs = millis() + POST_WRITE_QUIET_MS;
        lastError = "";
        return true;
      }
    }
  }

  rtuQuietUntilMs = millis() + POST_WRITE_QUIET_MS;
  if (gotReadback) lastError = F("Write verify mismatch");
  else lastError = F("Write ACK received, but read-back timed out");
  rtuErrors++;
  return false;
}

// PZEM-016 measurement block uses FC04 Input Registers, 0x0000..0x0009.
bool readInputUnit(uint8_t slave, uint16_t addr, uint16_t qty, uint16_t* out, uint32_t timeoutMs=RTU_POLL_TIMEOUT_MS) {
  if(!qty || qty>40) return false;
  uint8_t req[8]={slave,0x04,(uint8_t)(addr>>8),(uint8_t)addr,(uint8_t)(qty>>8),(uint8_t)qty,0,0};
  uint16_t crc=crc16Modbus(req,6); req[6]=crc&0xFF; req[7]=crc>>8;
  uint8_t resp[128]; size_t n=0;
  if(!rtuExchange(req,sizeof(req),resp,sizeof(resp),n,timeoutMs)) return false;
  if(resp[1]&0x80){ lastError=String("PZEM exception 0x")+String(resp[2],HEX); return false; }
  if(resp[1]!=0x04 || resp[2]!=qty*2 || n!=(size_t)(5+qty*2)){ lastError=F("Unexpected PZEM FC04 response"); return false; }
  for(uint16_t i=0;i<qty;i++) out[i]=((uint16_t)resp[3+i*2]<<8)|resp[4+i*2];
  return true;
}

// Forward declaration: reset verification is defined before the tariff persistence implementation.
bool pzemTariffSave(bool force);

// PZEM-016 vendor command 0x42 resets only the meter's internal accumulated-energy counter.
// This is intentionally NOT a normal Modbus register write. It must run only in the RTU worker.
bool resetPzemEnergyCommand() {
  if(!pzemEnabled || pzemSlave==modbusSlave){ lastError=F("PZEM unavailable or address conflict"); return false; }
  uint8_t req[4]={pzemSlave,0x42,0,0};
  uint16_t crc=crc16Modbus(req,2); req[2]=crc&0xFF; req[3]=crc>>8;
  uint8_t resp[16]={0}; size_t n=0;

  clearRs485Input();
  rs485TransmitMode(); RS485.write(req,sizeof(req)); RS485.flush(); delayMicroseconds(150); rs485ReceiveMode(); rtuTx++;
  uint32_t start=millis(), lastByte=start; bool gotAny=false; rtuWorkerLastMs=start;
  while((uint32_t)(millis()-start)<PZEM_RTU_TIMEOUT_MS){
    rtuWorkerLastMs=millis();
    while(RS485.available()){
      int c=RS485.read(); if(c>=0){gotAny=true;lastByte=millis();if(n<sizeof(resp))resp[n++]=(uint8_t)c;else{lastError=F("PZEM reset response too long");rtuErrors++;return false;}}
    }
    if(gotAny && (uint32_t)(millis()-lastByte)>=RTU_GAP_MS) break;
    vTaskDelay(pdMS_TO_TICKS(1));
  }
  if(!gotAny){rtuTimeouts++;rtuErrors++;lastError=F("PZEM reset timeout");return false;}
  if(n!=4){rtuErrors++;lastError=F("Unexpected PZEM reset response");return false;}
  uint16_t got=(uint16_t)resp[2]|((uint16_t)resp[3]<<8), calc=crc16Modbus(resp,2);
  if(got!=calc || resp[0]!=pzemSlave || resp[1]!=0x42){rtuErrors++;lastError=F("Invalid PZEM reset response");return false;}
  rtuRx++; lastError=""; return true;
}

// Verify reset by FC04 and re-anchor tariff baseline. T1/T2 totals are never cleared here.
bool resetPzemEnergyAndVerify(String& err) {
  uint32_t inverterLastOk=lastOkMs;
  vTaskDelay(pdMS_TO_TICKS(PZEM_BUS_GUARD_BEFORE_MS));
  bool cmdOk=resetPzemEnergyCommand();
  vTaskDelay(pdMS_TO_TICKS(250));
  uint16_t r[10]={0};
  bool readOk=readInputUnit(pzemSlave,0,10,r,PZEM_RTU_TIMEOUT_MS);
  lastOkMs=inverterLastOk;
  if(!readOk){err=cmdOk?F("Reset ACK received, but PZEM read-back failed"):lastError; return false;}
  uint32_t energyRaw=((uint32_t)r[6]<<16)|r[5]; // Wh
  // A lost 0x42 ACK is acceptable only if read-back proves the counter is reset.
  if(energyRaw>1U){err=cmdOk?String("PZEM energy reset verify failed: ")+energyRaw+" Wh":lastError; return false;}
  pzemEnergyKwh=energyRaw/1000.0f;
  pzemTariff.pzemBaseline_Wh=energyRaw; pzemTariff.baselineValid=1; pzemTariffDirty=true;
  if(!pzemTariffSave(true)){err=F("PZEM reset OK, but tariff baseline EEPROM save failed"); return false;}
  pzemUpdatedMs=millis(); pzemOnline=true;
  err=""; return true;
}

void pollPzem016() {
  if(!pzemEnabled || pzemSlave==modbusSlave) { pzemOnline=false; return; }
  uint16_t r[10]={0};
  // Give the shared half-duplex bus a quiet gap after ANENJI traffic. PZEM-016
  // does not need a fast refresh and some units answer noticeably slower.
  rtuWorkerLastMs=millis();
  vTaskDelay(pdMS_TO_TICKS(PZEM_BUS_GUARD_BEFORE_MS));
  rtuWorkerLastMs=millis();

  // PZEM traffic must not make inverterOnline() look healthy: preserve ANENJI lastOkMs.
  uint32_t inverterLastOk=lastOkMs;
  bool ok=readInputUnit(pzemSlave,0,10,r,PZEM_RTU_TIMEOUT_MS);
  lastOkMs=inverterLastOk;

  // Keep a small silent interval before the RTU worker returns to ANENJI polling.
  rtuWorkerLastMs=millis();
  vTaskDelay(pdMS_TO_TICKS(PZEM_BUS_GUARD_AFTER_MS));
  rtuWorkerLastMs=millis();
  if(!ok){
    // Keep the last valid PZEM sample visible through short RS-485 contention
    // (for example while Service/raw operations are being processed).
    // Declare it offline only after 15 s without a successful PZEM frame.
    pzemPollErrors++;
    if(!pzemUpdatedMs || (uint32_t)(millis()-pzemUpdatedMs)>15000UL) pzemOnline=false;
    return;
  }
  uint32_t currentRaw=((uint32_t)r[2]<<16)|r[1];
  uint32_t powerRaw=((uint32_t)r[4]<<16)|r[3];
  uint32_t energyRaw=((uint32_t)r[6]<<16)|r[5];
  pzemVoltage=r[0]/10.0f;
  pzemCurrent=currentRaw/1000.0f;
  pzemPower=powerRaw/10.0f;
  pzemEnergyKwh=energyRaw/1000.0f;
  pzemFrequency=r[7]/10.0f;
  pzemPf=r[8]/100.0f;
  pzemAlarm=(r[9]==0xFFFF);
  pzemOnline=true; pzemUpdatedMs=millis(); pzemPollOk++;
}

// ---------------- PZEM T1/T2 accounting ----------------
uint64_t pzemTariffTotal_mWh(){ return pzemTariff.t1_mWh + pzemTariff.t2_mWh; }

uint8_t currentTariff(){
  // T1 07:00..22:59, T2 23:00..06:59. Clock is local civil time.
  RtcDateTime now;
  if(!clockNow(now)) return 0;
  return (now.hour>=7 && now.hour<23) ? 1 : 2;
}

bool pzemTariffRecordValid(const PzemTariffPersist& r){
  if(r.magic!=PZEM_TARIFF_MAGIC || r.version!=PZEM_TARIFF_VERSION || r.size!=sizeof(PzemTariffPersist)) return false;
  return crc16Data((const uint8_t*)&r,sizeof(PzemTariffPersist)-sizeof(r.crc))==r.crc;
}

void pzemTariffLoad(){
  memset(&pzemTariff,0,sizeof(pzemTariff));
  pzemTariff.magic=PZEM_TARIFF_MAGIC; pzemTariff.version=PZEM_TARIFF_VERSION; pzemTariff.size=sizeof(PzemTariffPersist);
  if(!eepromPresent) return;
  bool found=false; uint32_t best=0;
  for(uint8_t i=0;i<PZEM_TARIFF_SLOT_COUNT;i++){
    PzemTariffPersist r={};
    if(!eepromReadBytes(PZEM_TARIFF_BASE+(uint16_t)i*PZEM_TARIFF_SLOT_SIZE,(uint8_t*)&r,sizeof(r))) continue;
    if(pzemTariffRecordValid(r) && (!found || r.sequence>=best)){ pzemTariff=r; pzemTariffSlot=i; best=r.sequence; found=true; }
  }
  pzemTariffLastSavedTotal_mWh=pzemTariffTotal_mWh();
}

bool pzemTariffSave(bool force=false){
  if(!eepromPresent) return false;
  uint64_t total=pzemTariffTotal_mWh(); uint32_t now=millis();
  if(!force && !pzemTariffDirty) return true;
  // Protect AT24C32: normal tariff accounting is accumulated in RAM and persisted
  // no more often than once every 5 minutes. Energy/power magnitude never bypasses
  // this limit; force=true is reserved for explicit/boundary/rebase events.
  if(!force && (uint32_t)(now-pzemTariffLastSaveMs)<PZEM_TARIFF_SAVE_INTERVAL_MS) return true;
  PzemTariffPersist r=pzemTariff; r.magic=PZEM_TARIFF_MAGIC; r.version=PZEM_TARIFF_VERSION; r.size=sizeof(PzemTariffPersist); r.sequence=pzemTariff.sequence+1;
  r.crc=crc16Data((const uint8_t*)&r,sizeof(r)-sizeof(r.crc));
  uint8_t next=(uint8_t)((pzemTariffSlot+1)%PZEM_TARIFF_SLOT_COUNT);
  if(!eepromWriteBytes(PZEM_TARIFF_BASE+(uint16_t)next*PZEM_TARIFF_SLOT_SIZE,(const uint8_t*)&r,sizeof(r))) return false;
  pzemTariff=r; pzemTariffSlot=next; pzemTariffDirty=false; pzemTariffLastSaveMs=now; pzemTariffLastSavedTotal_mWh=total; return true;
}

void servicePzemTariff(){
  if(!pzemOnline || !isfinite(pzemEnergyKwh)) return;
  uint32_t curWh=(uint32_t)llround((double)pzemEnergyKwh*1000.0);
  if(!pzemTariff.baselineValid){ pzemTariff.pzemBaseline_Wh=curWh; pzemTariff.baselineValid=1; pzemTariffDirty=true; pzemTariffSave(true); return; }
  if(curWh==pzemTariff.pzemBaseline_Wh){ pzemTariffSave(false); return; }
  // PZEM counter reset/replacement/wrap: re-anchor without inventing consumption.
  if(curWh<pzemTariff.pzemBaseline_Wh){ pzemTariff.pzemBaseline_Wh=curWh; pzemTariffDirty=true; pzemTariffSave(true); return; }
  uint32_t deltaWh=curWh-pzemTariff.pzemBaseline_Wh;
  // Reject implausibly huge discontinuities; re-anchor safely.
  if(deltaWh>10000U){ pzemTariff.pzemBaseline_Wh=curWh; pzemTariffDirty=true; pzemTariffSave(true); return; }
  uint8_t tariff=currentTariff();
  if(tariff==0) return; // do not allocate energy when RTC is invalid
  const bool tariffChanged=(pzemTariffLastTariff!=0 && tariff!=pzemTariffLastTariff);
  if(tariff==1) pzemTariff.t1_mWh += (uint64_t)deltaWh*1000ULL;
  else pzemTariff.t2_mWh += (uint64_t)deltaWh*1000ULL;
  pzemTariff.pzemBaseline_Wh=curWh; pzemTariffDirty=true;
  pzemTariffLastTariff=tariff;
  // At 07:00/23:00 persist the boundary immediately; otherwise obey 5-minute limit.
  pzemTariffSave(tariffChanged);
}

// ---------------- telemetry ----------------
const char* inverterModeText(uint8_t mode) {
  switch (mode) {
    case 0: return "Power On"; case 1: return "Standby"; case 2: return "Mains";
    case 3: return "Off-Grid"; case 4: return "Bypass"; case 5: return "Charging";
    case 6: return "Fault"; default: return "Unknown";
  }
}

void appendInverterEvent(uint8_t type, uint8_t bit, uint8_t code, bool active,
                         const char* severity, const char* message) {
  InverterEvent e = {};
  e.id = inverterEventNextId++;
  e.uptimeSec = millis()/1000UL;
  RtcDateTime eventDt = {};
  if (clockNow(eventDt)) {
    snprintf(e.timestamp, sizeof(e.timestamp), "%04u-%02u-%02u %02u:%02u:%02u",
             eventDt.year, eventDt.month, eventDt.day, eventDt.hour, eventDt.minute, eventDt.second);
  }
  e.type = type; e.bit = bit; e.code = code; e.active = active;
  snprintf(e.severity, sizeof(e.severity), "%s", severity ? severity : "INFO");
  snprintf(e.message, sizeof(e.message), "%s", message ? message : "");
  portENTER_CRITICAL(&inverterEventMux);
  inverterEvents[inverterEventHead] = e;
  inverterEventHead = (uint8_t)((inverterEventHead + 1) % INVERTER_EVENT_CAPACITY);
  if (inverterEventCount < INVERTER_EVENT_CAPACITY) inverterEventCount++;
  portEXIT_CRITICAL(&inverterEventMux);
}

void processInverterMasks(uint32_t faultMask, uint32_t warningMask) {
  if (!inverterMasksInitialized) {
    for (uint8_t bit=0; bit<INVERTER_FAULT_COUNT; ++bit)
      if (faultMask & (1UL<<bit)) appendInverterEvent(1,bit,0,true,"CRITICAL",INVERTER_FAULTS[bit]);
    for (uint8_t bit=0; bit<INVERTER_WARNING_COUNT; ++bit)
      if (warningMask & (1UL<<bit)) appendInverterEvent(2,bit,0,true,"WARNING",INVERTER_WARNINGS[bit]);
    inverterPrevFaultMask=faultMask; inverterPrevWarningMask=warningMask; inverterMasksInitialized=true; return;
  }
  uint32_t fc=faultMask^inverterPrevFaultMask, wc=warningMask^inverterPrevWarningMask;
  for (uint8_t bit=0; bit<INVERTER_FAULT_COUNT; ++bit) { uint32_t m=1UL<<bit; if(fc&m) appendInverterEvent(1,bit,0,(faultMask&m)!=0,"CRITICAL",INVERTER_FAULTS[bit]); }
  for (uint8_t bit=0; bit<INVERTER_WARNING_COUNT; ++bit) { uint32_t m=1UL<<bit; if(wc&m) appendInverterEvent(2,bit,0,(warningMask&m)!=0,"WARNING",INVERTER_WARNINGS[bit]); }
  inverterPrevFaultMask=faultMask; inverterPrevWarningMask=warningMask;
}

void processInverterMode() {
  if (!haveReg(201)) return;
  uint8_t mode=(uint8_t)telemetryRaw[1];
  if (!inverterPrevModeValid) { inverterPrevMode=mode; inverterPrevModeValid=true; return; }
  if (mode==inverterPrevMode) return;
  char msg[88]; snprintf(msg,sizeof(msg),"Mode: %s -> %s",inverterModeText(inverterPrevMode),inverterModeText(mode));
  appendInverterEvent(3,255,mode,true,mode==6?"CRITICAL":"INFO",msg);
  inverterPrevMode=mode;
}

void pollTelemetry() {
  // Called only by the dedicated RTU worker.
  // After a setting write, avoid immediately starting background RTU traffic.
  if ((int32_t)(rtuQuietUntilMs - millis()) > 0) return;

  uint16_t a[20], b[20], d[10];
  // Keep the web UI responsive when RS-485/inverter is disconnected.
  bool okA = readHolding(200, 20, a, RTU_POLL_TIMEOUT_MS);
  // If block A failed, don't burn a second timeout immediately.
  bool okB = false;
  if (okA) {
    delay(15);
    okB = readHolding(220, 20, b, RTU_POLL_TIMEOUT_MS);
  }

  if (okA) {
    for (int i = 0; i < 20; ++i) {
      telemetryRaw[i] = a[i];
      telemetryValid[i] = true;
    }
  }
  if (okB) {
    for (int i = 0; i < 20; ++i) {
      telemetryRaw[20 + i] = b[i];
      telemetryValid[20 + i] = true;
    }
  }

  bool okDiag = false;
  if (okA) {
    delay(15);
    okDiag = readHolding(100, 10, d, RTU_POLL_TIMEOUT_MS);
  }
  if (okDiag) {
    for (int i=0;i<10;++i) inverterDiagRaw[i]=d[i];
    inverterDiagValid=true; inverterDiagUpdatedMs=millis();
    inverterFaultMask=((uint32_t)d[0]<<16)|d[1];
    inverterWarningUnmaskedMask=((uint32_t)d[4]<<16)|d[5];
    inverterWarningMask=((uint32_t)d[8]<<16)|d[9];
    processInverterMasks(inverterFaultMask,inverterWarningMask);
  }

  if (okA || okB) {
    telemetryUpdatedMs = millis();
    rtuConsecutivePollFailures = 0;
    processInverterMode();
  } else {
    rtuConsecutivePollFailures++;
    if (rtuConsecutivePollFailures >= RTU_RECOVERY_AFTER_FAILED_POLLS) {
      recoverRs485Uart();
    }
  }
}

bool haveReg(uint16_t reg) {
  return reg >= 200 && reg <= 239 && telemetryValid[reg - 200];
}

float regScaled(uint16_t reg, float scale, bool signedValue = true) {
  if (!haveReg(reg)) return NAN;
  int32_t v = signedValue ? asS16(telemetryRaw[reg - 200]) : telemetryRaw[reg - 200];
  return ((float)v) / scale;
}

bool inverterOnline() {
  // Two missed poll periods + margin => offline.
  if (!telemetryUpdatedMs || !lastOkMs) return false;
  uint32_t now = millis();
  return (uint32_t)(now - lastOkMs) < (POLL_OFFLINE_INTERVAL_MS + 2500);
}

// ---------------- battery-system detection ----------------
BatterySystemDetect batteryDetectCache = {0,false,NAN,NAN,NAN,String()};
uint32_t batteryDetectCacheMs = 0;
const uint32_t BATTERY_DETECT_CACHE_TTL_MS = 30000;

// We do NOT identify the exact inverter model. We identify the battery-voltage family
// from two independent clues: live battery voltage (reg 215) and configured Bulk/Float.
// Profiles are writable only when the clues agree.
uint8_t voltageFamily(float v) {
  if (v >= 18.0f && v <= 35.0f) return 24;
  if (v >= 36.0f && v <= 65.0f) return 48;
  return 0;
}

BatterySystemDetect detectBatterySystemFresh() {
  BatterySystemDetect d = {0,false,NAN,NAN,NAN,String()};

  // Never touch RS-485 from HTTP. Live voltage comes from telemetry cache; Bulk/Float
  // come from the settings cache maintained by the RTU worker.
  if (haveReg(215)) d.batteryV = regScaled(215, 10, false);

  uint16_t bulkRaw=0, floatRaw=0;
  bool bulkOk = getCachedSettingRaw(324, bulkRaw);
  bool floatOk = getCachedSettingRaw(325, floatRaw);
  if (bulkOk) d.bulkV = bulkRaw/10.0f;
  if (floatOk) d.floatV = floatRaw/10.0f;

  uint8_t fBat = isnan(d.batteryV) ? 0 : voltageFamily(d.batteryV);
  uint8_t fBulk = isnan(d.bulkV) ? 0 : voltageFamily(d.bulkV);
  uint8_t fFloat = isnan(d.floatV) ? 0 : voltageFamily(d.floatV);

  uint8_t cfgFamily = 0;
  if (fBulk && fFloat && fBulk == fFloat) cfgFamily = fBulk;
  else if (fBulk && !fFloat) cfgFamily = fBulk;
  else if (!fBulk && fFloat) cfgFamily = fFloat;

  if (fBat && cfgFamily && fBat == cfgFamily) {
    d.systemV = fBat; d.verified = true;
    d.reason = F("battery voltage + cached charge settings agree");
  } else if (fBat && cfgFamily && fBat != cfgFamily) {
    d.reason = F("battery voltage and cached charge settings disagree");
  } else if (fBat) {
    d.systemV = fBat; d.reason = F("only live battery voltage available; settings refresh pending");
  } else if (cfgFamily) {
    d.systemV = cfgFamily; d.reason = F("only cached charge settings available; not verified");
  } else {
    d.reason = F("not enough cached data yet");
  }
  return d;
}

bool isBatteryVoltageRegister(uint16_t reg) {
  return reg==323 || reg==324 || reg==325 || reg==326 || reg==327 || reg==329 || reg==334;
}

// ---------------- setting metadata ----------------
BatterySystemDetect detectBatterySystem() {
  if (batteryDetectCacheMs && (uint32_t)(millis()-batteryDetectCacheMs) < BATTERY_DETECT_CACHE_TTL_MS)
    return batteryDetectCache;
  batteryDetectCache=detectBatterySystemFresh();
  batteryDetectCacheMs=millis();
  return batteryDetectCache;
}

const SettingDef SETTINGS[] = {
  {300,"Основные","AC output mode",SK_SELECT,1,0,4,true},
  {301,"Основные","Приоритет выхода",SK_SELECT,1,1,4,true},
  {302,"Прочие","Диапазон входного напряжения",SK_SELECT,1,0,2,true},
  {303,"Прочие","Зуммер",SK_SELECT,1,0,3,true},
  {305,"Прочие","Подсветка LCD",SK_SELECT,1,0,1,true},
  {306,"Прочие","Автовозврат LCD",SK_SELECT,1,0,1,true},
  {307,"Прочие","Энергосбережение",SK_SELECT,1,0,1,true},
  {308,"Прочие","Автоперезапуск после перегрузки",SK_SELECT,1,0,1,true},
  {309,"Прочие","Автоперезапуск после перегрева",SK_SELECT,1,0,1,true},
  {310,"Прочие","Overload bypass",SK_SELECT,1,0,1,true},
  {313,"АКБ","Выравнивание АКБ",SK_SELECT,1,0,1,true},
  {316,"Прочие","Dry contact / Grounding box",SK_SELECT,1,0,1,true},
  {320,"Основные","Выходное напряжение",SK_SELECT,1,2200,2400,true},
  {321,"Основные","Выходная частота",SK_SELECT,1,5000,6000,true},
  {322,"АКБ","Тип АКБ",SK_SELECT,1,0,2,true},
  {323,"АКБ","Защита от перенапряжения АКБ",SK_NUMBER,10,0,6553.5,true},
  {324,"АКБ","Bulk / CV",SK_NUMBER,10,0,6553.5,true},
  {325,"АКБ","Float",SK_NUMBER,10,0,6553.5,true},
  {326,"АКБ","Возврат к сети, напряжение",SK_NUMBER,10,0,6553.5,true},
  {327,"АКБ","Low DC в режиме сети",SK_NUMBER,10,0,6553.5,true},
  {329,"АКБ","Low DC off-grid",SK_NUMBER,10,0,6553.5,true},
  {330,"АКБ","CV -> Float, время",SK_NUMBER,1,0,900,true},
  {331,"АКБ","Приоритет зарядки",SK_SELECT,1,1,4,true},
  {332,"АКБ","Макс. ток зарядки",SK_NUMBER,10,10,80,true},
  {333,"АКБ","Макс. ток зарядки от сети",SK_NUMBER,10,2,80,true},
  {334,"АКБ","Напряжение equalization",SK_NUMBER,10,0,6553.5,true},
  {335,"АКБ","Equalization time",SK_NUMBER,1,0,900,true},
  {336,"АКБ","Equalization timeout",SK_NUMBER,1,0,900,true},
  {337,"АКБ","Equalization interval",SK_NUMBER,1,1,90,true},
  {338,"Прочие","Automatic mains output",SK_SELECT,1,0,1,true},
  {341,"SOC","Low DC SOC в режиме сети",SK_NUMBER,1,20,50,true},
  {342,"SOC","Recovery SOC",SK_NUMBER,1,60,100,true},
  {343,"SOC","Off-grid cut-off SOC",SK_NUMBER,1,3,30,true},
  {344,"Основные","Reserved 344 — запись заблокирована",SK_NUMBER,1,0,65535,false},
  {351,"АКБ","Макс. ток разряда АКБ",SK_NUMBER,1,0,65535,true},
  {406,"Remote","Turn-on mode",SK_SELECT,1,0,2,true}
};

const size_t SETTINGS_COUNT = sizeof(SETTINGS) / sizeof(SETTINGS[0]);

const SettingDef* findSetting(uint16_t reg) {
  for (size_t i = 0; i < SETTINGS_COUNT; ++i)
    if (SETTINGS[i].reg == reg) return &SETTINGS[i];
  return nullptr;
}

bool validSelectRaw(uint16_t reg, uint16_t raw) {
  switch (reg) {
    case 300: return raw <= 4;
    case 301: return raw >= 1 && raw <= 4;
    case 302: return raw <= 2;
    case 303: return raw <= 3;
    case 305: case 306: case 307: case 308: case 309: case 310: case 313: case 316: case 338:
      return raw <= 1;
    case 320: return raw == 2200 || raw == 2300 || raw == 2400;
    case 321: return raw == 5000 || raw == 6000;
    case 322: return raw <= 2;
    case 331: return raw >= 1 && raw <= 4;
    case 406: return raw <= 2;
    default: return true;
  }
}

bool validateRaw(uint16_t reg, uint16_t raw, String& err) {
  const SettingDef* s = findSetting(reg);
  if (!s || !s->writable) {
    err = F("Register is not in writable allow-list");
    return false;
  }
  if (s->kind == SK_SELECT) {
    if (!validSelectRaw(reg, raw)) {
      err = F("Invalid select value");
      return false;
    }
    return true;
  }
  float userVal = ((float)raw) / s->scale;
  if (userVal < s->minVal || userVal > s->maxVal) {
    err = F("Value outside allowed range");
    return false;
  }

  uint16_t other=0;
  if (reg==332 && getCachedSettingRaw(333,other) && raw < other) {
    err = F("Maximum charge current must be >= mains charge current"); return false;
  }
  if (reg==333 && getCachedSettingRaw(332,other) && raw > other) {
    err = F("Mains charge current must be <= maximum charge current"); return false;
  }
  if (reg==343 && getCachedSettingRaw(341,other) && raw > other) {
    err = F("Off-grid cut-off SOC must be <= mains SOC protection"); return false;
  }

  BatterySystemDetect bd=detectBatterySystem();
  uint16_t J=(bd.systemV==24?2:(bd.systemV==48?4:0));
  if(J){
    uint16_t A=0,B=0,C=0,D=0,E=0,Fv=0;
    getCachedSettingRaw(323,A); getCachedSettingRaw(324,B); getCachedSettingRaw(325,C);
    getCachedSettingRaw(326,D); getCachedSettingRaw(327,E); getCachedSettingRaw(329,Fv);
    if(reg==323 && B && (raw < B+10*J || raw > 165*J)){err=F("Battery OVP violates B/J limits");return false;}
    if(reg==324 && C && A && (raw < C || raw > A-10*J)){err=F("Bulk/CV violates C/A/J limits");return false;}
    if(reg==325 && B && (raw < 120*J || raw > B)){err=F("Float violates J/B limits");return false;}
    if(reg==326 && raw!=0 && B && E && (raw < max((uint16_t)(120*J),E) || raw > B-5*J)){err=F("Mains recovery voltage violates B/E/J limits");return false;}
    if(reg==327 && Fv){
      uint16_t lo=max((uint16_t)(110*J),Fv), hi=(uint16_t)(143*J); if(D) hi=min(hi,D);
      if(raw<lo || raw>hi){err=F("Mains low-voltage point violates D/F/J limits");return false;}
    }
    if(reg==329 && E && (raw < 100*J || raw > min((uint16_t)(135*J),E))){err=F("Off-grid low-voltage point violates E/J limits");return false;}
    if(reg==334 && C && A && (raw < C || raw > A-5*J)){err=F("Equalization voltage violates C/A/J limits");return false;}
  }
  return true;
}

// ---------------- profiles ----------------
const ProfileReg PROFILE_1P[] = {
  {313,0}, {322,2}, {332,150}, {333,100},
  {324,280}, {325,272}, {327,232}, {329,220},
  {341,20}, {342,30}, {343,15}, {351,80}
};

const ProfileReg PROFILE_2P[] = {
  {313,0}, {322,2}, {332,150}, {333,100},
  {324,280}, {325,272}, {327,232}, {329,220},
  {341,20}, {342,30}, {343,15}, {351,120}
};

// Historical 48 V / 51.2 V profiles from the original Python application.
// Visible for reference, but blocked from writing on this 24 V inverter.
const ProfileReg PROFILE_48V_STANDARD[] = {
  {313,0}, {322,2}, {332,100}, {333,100},
  {324,564}, {325,540}, {327,460}, {329,440},
  {341,20}, {342,30}, {343,15}, {351,95}
};

const ProfileReg PROFILE_48V_LONG_LIFE[] = {
  {313,0}, {322,2}, {332,100}, {333,100},
  {324,560}, {325,540}, {327,460}, {329,440},
  {341,20}, {342,30}, {343,15}, {351,80}
};

// ---------------- Modbus RTU gateway removed in v0.10.0 ----------------

// ---------------- small JSON parser helpers ----------------
bool jsonFindNumber(const String& body, const char* key, double& value) {
  String needle = String("\"") + key + "\"";
  int p = body.indexOf(needle);
  if (p < 0) return false;
  p = body.indexOf(':', p + needle.length());
  if (p < 0) return false;
  p++;
  while (p < (int)body.length() && isspace((unsigned char)body[p])) p++;
  int e = p;
  while (e < (int)body.length()) {
    char c = body[e];
    if ((c >= '0' && c <= '9') || c == '-' || c == '+' || c == '.' || c == 'e' || c == 'E')
      e++;
    else
      break;
  }
  if (e == p) return false;
  value = body.substring(p, e).toDouble();
  return true;
}

bool jsonFindString(const String& body, const char* key, String& value) {
  String needle = String("\"") + key + "\"";
  int p = body.indexOf(needle);
  if (p < 0) return false;
  p = body.indexOf(':', p + needle.length());
  if (p < 0) return false;
  p++;
  while (p < (int)body.length() && isspace((unsigned char)body[p])) p++;
  if (p >= (int)body.length() || body[p] != '"') return false;
  p++;
  int e = body.indexOf('"', p);
  if (e < 0) return false;
  value = body.substring(p, e);
  return true;
}

bool jsonFindBool(const String& body, const char* key, bool& value) {
  String needle = String("\"") + key + "\"";
  int p = body.indexOf(needle);
  if (p < 0) return false;
  p = body.indexOf(':', p + needle.length());
  if (p < 0) return false;
  p++;
  while (p < (int)body.length() && isspace((unsigned char)body[p])) p++;
  if (body.substring(p, p + 4) == "true") { value = true; return true; }
  if (body.substring(p, p + 5) == "false") { value = false; return true; }
  return false;
}

bool parseIp(const String& s, IPAddress& ip) {
  return ip.fromString(s);
}

String macSuffix() {
  uint64_t chip = ESP.getEfuseMac();
  char buf[7];
  snprintf(buf, sizeof(buf), "%06llX", (unsigned long long)(chip & 0xFFFFFFULL));
  return String(buf);
}

String generateDevicePassword() {
  static const char alphabet[] = "ABCDEFGHJKLMNPQRSTUVWXYZ23456789";
  char buf[14];
  uint32_t r1 = esp_random(), r2 = esp_random();
  uint64_t r = ((uint64_t)r1 << 32) | r2;
  for (int i = 0; i < 12; ++i) {
    buf[i] = alphabet[(r >> ((i % 10) * 5)) & 31];
    if (i == 3 || i == 7) buf[i] = '-';
  }
  buf[12] = 0;
  return String(buf);
}

void loadPersistentConfig() {
  wifiPrefs.begin("wifi_cfg", false);
  devicePrefs.begin("device_cfg", false);
  appPrefs.begin("anenji", false);
  loadScheduleTasks();

  wifiSsid = wifiPrefs.getString("ssid", "");
  wifiPass = wifiPrefs.getString("pass", "");
  netUseStatic = wifiPrefs.getBool("static", false);
  netLocalIp = wifiPrefs.getString("ip", "192.168.88.158");
  netGateway = wifiPrefs.getString("gw", "192.168.88.1");
  netMask = wifiPrefs.getString("mask", "255.255.255.0");
  netDns = wifiPrefs.getString("dns", "192.168.88.1");

  setupApPassword = devicePrefs.getString("setup_pass", "");
  if (setupApPassword.length() < 8) {
    setupApPassword = generateDevicePassword();
    devicePrefs.putString("setup_pass", setupApPassword);
  }

  adminPassword = devicePrefs.getString("admin_pass", "");
  if (adminPassword.length() < 8) {
    adminPassword = setupApPassword;
    devicePrefs.putString("admin_pass", adminPassword);
  }

  activeProfile = appPrefs.getString("profile", "ANJ_24V_8S_1P");
  uint32_t savedSlave = appPrefs.getUInt("modbus_slave", DEFAULT_MODBUS_SLAVE);
  modbusSlave = (savedSlave >= 1 && savedSlave <= 247) ? (uint8_t)savedSlave : DEFAULT_MODBUS_SLAVE;
  ntpServer = appPrefs.getString("ntp_server", NTP_DEFAULT_SERVER);
  ntpServer.trim(); if(ntpServer.length()<3 || ntpServer.length()>63) ntpServer=NTP_DEFAULT_SERVER;
  ntpUtcOffsetMin = (int16_t)appPrefs.getInt("ntp_utc_min", 180);
  if (ntpUtcOffsetMin < -720 || ntpUtcOffsetMin > 840) ntpUtcOffsetMin = 180;
  pzemEnabled = appPrefs.getBool("pzem_en", true);
  uint32_t ps=appPrefs.getUInt("pzem_slave", PZEM_DEFAULT_SLAVE);
  pzemSlave=(ps>=1 && ps<=247)?(uint8_t)ps:PZEM_DEFAULT_SLAVE;
  hallEnabled = appPrefs.getBool("hall_en", false);
  uint32_t ha=appPrefs.getUInt("hall_addr", 0);
  hallAdsAddress=(ha==0 || (ha>=ADS1115_ADDR_FIRST && ha<=ADS1115_ADDR_LAST))?(uint8_t)ha:0;
  uint32_t hc=appPrefs.getUInt("hall_ch", 0); hallChannel=(hc<=3)?(uint8_t)hc:0;
  hallZeroMv=appPrefs.getFloat("hall_zero",2500.0f);
  if(hallZeroMv<0.0f || hallZeroMv>5500.0f) hallZeroMv=2500.0f;
  hallSensitivityMvPerA=appPrefs.getFloat("hall_sens",20.0f);
  if(hallSensitivityMvPerA<0.05f || hallSensitivityMvPerA>1000.0f) hallSensitivityMvPerA=20.0f;
  hallInvert=appPrefs.getBool("hall_inv",false);
  setupApSsid = String("ANENJI-SETUP-") + macSuffix();

  // Recovery credentials are intentionally printed to the local serial console.
  // They are not exposed through the normal web UI.
  Serial.println();
  Serial.println(F("========== ANENJI AUTH =========="));
  Serial.print(F("Setup AP:       ")); Serial.println(setupApSsid);
  Serial.print(F("Setup password: ")); Serial.println(setupApPassword);
  Serial.print(F("Admin password: ")); Serial.println(adminPassword);
  Serial.println(F("================================="));
}


// ---------------- PZCT-DC63 Hall current sensor / ADS1115 ----------------
uint8_t hallResolveAddress() {
  if(hallAdsAddress>=ADS1115_ADDR_FIRST && hallAdsAddress<=ADS1115_ADDR_LAST) {
    if(i2cProbe(hallAdsAddress)) { hallResolvedAddress=hallAdsAddress; return hallResolvedAddress; }
    hallResolvedAddress=0; return 0;
  }
  for(uint8_t a=ADS1115_ADDR_FIRST;a<=ADS1115_ADDR_LAST;a++) {
    if(i2cProbe(a)) { hallResolvedAddress=a; return a; }
  }
  hallResolvedAddress=0; return 0;
}

bool hallReadMv(float& mv) {
  uint8_t addr=hallResolveAddress();
  if(!addr || hallChannel>3) return false;
  // ADS1115: single-shot, AINx vs GND, PGA +/-6.144 V, 128 SPS, comparator disabled.
  uint16_t cfg=(uint16_t)(0x8000 | ((uint16_t)(4+hallChannel)<<12) | 0x0100 | (4u<<5) | 0x0003);
  Wire.beginTransmission(addr); Wire.write((uint8_t)0x01); Wire.write((uint8_t)(cfg>>8)); Wire.write((uint8_t)cfg);
  if(Wire.endTransmission()!=0) return false;
  delay(10);
  Wire.beginTransmission(addr); Wire.write((uint8_t)0x00);
  if(Wire.endTransmission(false)!=0) return false;
  if(Wire.requestFrom((int)addr,2)!=2) return false;
  int16_t raw=(int16_t)(((uint16_t)Wire.read()<<8)|Wire.read());
  mv=(float)raw*0.1875f; // +/-6.144 V range -> 187.5 uV/LSB
  return true;
}

bool hallAverageMv(float& mv, uint8_t samples=6) {
  if(samples<1) samples=1; if(samples>16) samples=16;
  float sum=0.0f; uint8_t ok=0;
  for(uint8_t i=0;i<samples;i++) { float v=0; if(hallReadMv(v)){sum+=v;ok++;} delay(2); }
  if(ok<((samples+1)/2)) return false;
  mv=sum/(float)ok; return true;
}

void serviceHallCurrent() {
  if(!hallEnabled) { hallOnline=false; hallCurrentA=NAN; hallInputMv=NAN; return; }
  uint32_t now=millis(); if(hallLastPollMs && now-hallLastPollMs<HALL_POLL_INTERVAL_MS) return; hallLastPollMs=now;
  float mv=0; if(!hallAverageMv(mv,3)) { hallOnline=false; return; }
  hallInputMv=mv; hallOnline=true; hallUpdatedMs=now;
  float a=(mv-hallZeroMv)/hallSensitivityMvPerA; if(hallInvert) a=-a;
  if(fabsf(a)<0.03f) a=0.0f; hallCurrentA=a;
}

// ---------------- DS1307/DS3231-common RTC + scheduler ----------------
uint8_t bcdToDec(uint8_t v) { return (uint8_t)((v >> 4) * 10 + (v & 0x0F)); }
uint8_t decToBcd(uint8_t v) { return (uint8_t)(((v / 10) << 4) | (v % 10)); }

bool i2cProbe(uint8_t addr) {
  Wire.beginTransmission(addr);
  return Wire.endTransmission() == 0;
}

bool rtcRead(RtcDateTime& dt) {
  dt.valid = false;
  Wire.beginTransmission(RTC_I2C_ADDR);
  Wire.write((uint8_t)0x00);
  if (Wire.endTransmission(false) != 0) return false;
  if (Wire.requestFrom((int)RTC_I2C_ADDR, 7) != 7) return false;

  uint8_t secRaw = Wire.read();
  uint8_t minRaw = Wire.read();
  uint8_t hourRaw = Wire.read();
  Wire.read(); // DOW: scheduler calculates weekday from the date itself
  uint8_t dayRaw = Wire.read();
  uint8_t monthRaw = Wire.read();
  uint8_t yearRaw = Wire.read();

  // DS1307: CH=1 in seconds bit7 means oscillator stopped. On DS3231 this bit is 0.
  bool oscillatorStopped = (secRaw & 0x80) != 0;
  secRaw &= 0x7F;

  uint8_t hour;
  if (hourRaw & 0x40) { // 12-hour mode
    uint8_t h12=bcdToDec(hourRaw & 0x1F);
    bool pm=(hourRaw & 0x20)!=0;
    hour=(uint8_t)((h12%12)+(pm?12:0));
  } else hour=bcdToDec(hourRaw & 0x3F);

  dt.second = bcdToDec(secRaw);
  dt.minute = bcdToDec(minRaw & 0x7F);
  dt.hour = hour;
  dt.day = bcdToDec(dayRaw & 0x3F);
  dt.month = bcdToDec(monthRaw & 0x1F);
  dt.year = 2000 + bcdToDec(yearRaw);

  dt.valid = !oscillatorStopped &&
             dt.year >= 2024 && dt.year <= 2099 &&
             dt.month >= 1 && dt.month <= 12 &&
             dt.day >= 1 && dt.day <= 31 &&
             dt.hour <= 23 && dt.minute <= 59 && dt.second <= 59;
  return true;
}

bool rtcWrite(const RtcDateTime& dt) {
  if (dt.year < 2024 || dt.year > 2099 || dt.month < 1 || dt.month > 12 ||
      dt.day < 1 || dt.day > 31 || dt.hour > 23 || dt.minute > 59 || dt.second > 59) return false;
  Wire.beginTransmission(RTC_I2C_ADDR);
  Wire.write((uint8_t)0x00);
  Wire.write(decToBcd(dt.second) & 0x7F); // DS1307 CH=0 -> oscillator enabled
  Wire.write(decToBcd(dt.minute));
  Wire.write(decToBcd(dt.hour));         // force 24-hour mode
  Wire.write((uint8_t)1);
  Wire.write(decToBcd(dt.day));
  Wire.write(decToBcd(dt.month));
  Wire.write(decToBcd((uint8_t)(dt.year - 2000)));
  return Wire.endTransmission() == 0;
}

// 0=Monday ... 6=Sunday
uint8_t weekdayMon0(uint16_t y, uint8_t m, uint8_t d) {
  // Sakamoto: 0=Sunday. Convert to Monday-based.
  static const uint8_t t[] = {0,3,2,5,0,3,5,1,4,6,2,4};
  uint16_t yy = y;
  if (m < 3) yy--;
  uint8_t sun0 = (yy + yy/4 - yy/100 + yy/400 + t[m-1] + d) % 7;
  return (uint8_t)((sun0 + 6) % 7);
}

String rtcIso(const RtcDateTime& dt) {
  if (!dt.valid) return String();
  char b[24];
  snprintf(b, sizeof(b), "%04u-%02u-%02uT%02u:%02u:%02u",
           dt.year, dt.month, dt.day, dt.hour, dt.minute, dt.second);
  return String(b);
}


// ---------------- AT24C32 + battery statistics ----------------
uint16_t crc16Data(const uint8_t* data, size_t len) { return crc16Modbus(data,len); }

bool eepromReadBytes(uint16_t addr, uint8_t* dst, size_t len) {
  if (!eepromPresent || !dst || addr + len > AT24C32_SIZE) return false;
  while (len) {
    uint8_t chunk=(uint8_t)min((size_t)28,len);
    Wire.beginTransmission(eepromI2cAddr);
    Wire.write((uint8_t)(addr>>8)); Wire.write((uint8_t)addr);
    if (Wire.endTransmission(false)!=0) return false;
    int got=Wire.requestFrom((int)eepromI2cAddr,(int)chunk);
    if (got!=chunk) return false;
    for(uint8_t i=0;i<chunk;i++) *dst++=Wire.read();
    addr+=chunk; len-=chunk;
  }
  return true;
}

bool eepromWriteBytes(uint16_t addr, const uint8_t* src, size_t len) {
  if (!eepromPresent || !src || addr + len > AT24C32_SIZE) return false;
  while (len) {
    uint8_t room=(uint8_t)(AT24C32_PAGE_SIZE-(addr%AT24C32_PAGE_SIZE));
    uint8_t chunk=(uint8_t)min((size_t)room,len);
    chunk=(uint8_t)min((int)chunk,26); // 2 address bytes + payload within Wire buffer
    Wire.beginTransmission(eepromI2cAddr);
    Wire.write((uint8_t)(addr>>8)); Wire.write((uint8_t)addr);
    for(uint8_t i=0;i<chunk;i++) Wire.write(src[i]);
    if (Wire.endTransmission()!=0) return false;
    delay(6); // AT24C32 write-cycle time
    addr+=chunk; src+=chunk; len-=chunk;
    feedTaskWatchdog();
  }
  return true;
}

void detectExternalEeprom() {
  eepromPresent=false; eepromI2cAddr=0;
  for(uint8_t a=AT24C32_ADDR_FIRST;a<=AT24C32_ADDR_LAST;a++) {
    if(i2cProbe(a)){eepromPresent=true;eepromI2cAddr=a;break;}
  }
}

uint32_t rtcDateKey() {
  RtcDateTime now;
  if(!clockNow(now)) return 0;
  return (uint32_t)now.year*10000UL+(uint32_t)now.month*100UL+now.day;
}

float profileNominalVoltage() {
  return activeProfile.startsWith("ANJ_48V") ? 51.2f : 25.6f;
}
uint32_t profileNominalEnergy_mWh() {
  if(activeProfile=="ANJ_24V_8S_1P") return 2560000UL;
  if(activeProfile=="ANJ_24V_8S_2P") return 5120000UL;
  return 5120000UL;
}
uint32_t profileNominalCapacity_mAh() {
  const float v=profileNominalVoltage();
  const uint32_t e=profileNominalEnergy_mWh();
  return (v>1.0f) ? (uint32_t)lround((double)e/(double)v) : 0;
}
uint32_t calibratedCapacity_mAh() {
  const float v=profileNominalVoltage();
  return (batteryStats.calibratedEnergy_mWh && v>1.0f)
    ? (uint32_t)lround((double)batteryStats.calibratedEnergy_mWh/(double)v) : 0;
}
bool calibratedCapacityPlausible() {
  const uint32_t nom=profileNominalCapacity_mAh();
  const uint32_t cal=calibratedCapacity_mAh();
  if(!nom || !cal) return false;
  // A SOC-derived estimate far outside the profile is treated as invalid.
  // This protects against the coarse inverter SOC typical for LiFePO4.
  return cal >= (uint32_t)((uint64_t)nom*60/100) && cal <= (uint32_t)((uint64_t)nom*140/100);
}
uint32_t batteryReferenceEnergy_mWh() {
  // EFC is intentionally anchored to DESIGN/profile capacity, not to SOC-derived calibration.
  return profileNominalEnergy_mWh();
}
uint32_t batteryReferenceCapacity_mAh() {
  return profileNominalCapacity_mAh();
}
float batteryEfc() {
  // LiFePO4 EFC = cumulative discharged Ah / nominal design Ah.
  // Partial discharges accumulate. Calibration cannot retroactively change cycle count.
  const uint32_t ref=profileNominalCapacity_mAh();
  return ref ? (float)((double)batteryStats.discharged_mAh/(double)ref) : 0.0f;
}

void batteryStatsDefaults() {
  memset(&batteryStats,0,sizeof(batteryStats));
  batteryStats.magic=BAT_STATS_MAGIC; batteryStats.version=BAT_STATS_VERSION;
  batteryStats.size=sizeof(BatteryStatsPersist); batteryStats.sequence=1;
  batteryStats.dayDate=rtcDateKey();
  batteryStats.dayStartCharged_mWh=0; batteryStats.dayStartDischarged_mWh=0;
  batteryStats.dayStartDischarged_mAh=0;
  batteryStats.firstDate=batteryStats.dayDate;
  batteryStatsSlot=0; batteryDailySlot=0;
  batteryStatsDirty=true;
}

bool batteryStatsRecordValid(const BatteryStatsPersist& r) {
  if(r.magic!=BAT_STATS_MAGIC || r.version!=BAT_STATS_VERSION || r.size!=sizeof(BatteryStatsPersist)) return false;
  uint16_t c=crc16Data((const uint8_t*)&r,sizeof(BatteryStatsPersist)-sizeof(r.crc));
  return c==r.crc;
}

void batteryStatsLoad() {
  batteryStatsDefaults();
  if(!eepromPresent) return;
  bool found=false; BatteryStatsPersist best={}; uint8_t bestSlot=0;
  for(uint8_t i=0;i<BAT_STATS_SLOT_COUNT;i++){
    BatteryStatsPersist r={};
    if(!eepromReadBytes((uint16_t)i*BAT_STATS_SLOT_SIZE,(uint8_t*)&r,sizeof(r))) continue;
    if(!batteryStatsRecordValid(r)) continue;
    if(!found || (int32_t)(r.sequence-best.sequence)>0){best=r;bestSlot=i;found=true;}
  }
  if(found){
    batteryStats=best;batteryStatsSlot=bestSlot;batteryStatsDirty=false;
  } else {
    // One-time migration from v2. Ah throughput was not stored then, so derive
    // a close estimate from Wh / nominal pack voltage. From this version on,
    // Ah is integrated directly from battery current.
    bool oldFound=false; BatteryStatsPersistV2 oldBest={}; uint8_t oldSlot=0;
    for(uint8_t i=0;i<BAT_STATS_SLOT_COUNT;i++){
      BatteryStatsPersistV2 r={};
      if(!eepromReadBytes((uint16_t)i*BAT_STATS_SLOT_SIZE,(uint8_t*)&r,sizeof(r))) continue;
      if(r.magic!=BAT_STATS_MAGIC || r.version!=2 || r.size!=sizeof(BatteryStatsPersistV2)) continue;
      uint16_t c=crc16Data((const uint8_t*)&r,sizeof(BatteryStatsPersistV2)-sizeof(r.crc));
      if(c!=r.crc) continue;
      if(!oldFound || (int32_t)(r.sequence-oldBest.sequence)>0){oldBest=r;oldSlot=i;oldFound=true;}
    }
    if(oldFound){
      batteryStatsDefaults();
      batteryStats.sequence=oldBest.sequence;
      batteryStats.charged_mWh=oldBest.charged_mWh;
      batteryStats.discharged_mWh=oldBest.discharged_mWh;
      const double nv=profileNominalVoltage();
      batteryStats.charged_mAh=(uint64_t)llround((double)oldBest.charged_mWh/nv);
      batteryStats.discharged_mAh=(uint64_t)llround((double)oldBest.discharged_mWh/nv);
      batteryStats.chargeSeconds=oldBest.chargeSeconds;
      batteryStats.dischargeSeconds=oldBest.dischargeSeconds;
      batteryStats.maxCharge_mA=oldBest.maxCharge_mA;
      batteryStats.maxDischarge_mA=oldBest.maxDischarge_mA;
      batteryStats.calibratedEnergy_mWh=oldBest.calibratedEnergy_mWh;
      batteryStats.dayDate=oldBest.dayDate;
      batteryStats.dayStartCharged_mWh=oldBest.dayStartCharged_mWh;
      batteryStats.dayStartDischarged_mWh=oldBest.dayStartDischarged_mWh;
      batteryStats.dayStartDischarged_mAh=(uint64_t)llround((double)oldBest.dayStartDischarged_mWh/nv);
      batteryStats.firstDate=oldBest.firstDate;
      batteryStats.calibrationActive=oldBest.calibrationActive;
      batteryStats.calibrationStartSoc=oldBest.calibrationStartSoc;
      batteryStats.calibrationEndSoc=oldBest.calibrationEndSoc;
      batteryStats.calibrationNetDischarge_mWh=oldBest.calibrationNetDischarge_mWh;
      batteryStatsSlot=oldSlot;
      batteryStatsDirty=true;
    }
  }
  // Controlled calibration uses RAM baselines for Ah throughput.  It is intentionally
  // not resumed after an ESP32 reboot because that would make the Ah result ambiguous.
  batteryCalibration = {};
  batteryCalibration.endSoc=batteryStats.calibrationEndSoc?batteryStats.calibrationEndSoc:20;
  if(batteryStats.calibrationActive){
    batteryStats.calibrationActive=0;
    batteryStats.calibrationNetDischarge_mWh=0;
    batteryStatsDirty=true;
    strncpy(batteryCalibration.status,"cancelled after reboot; start a new controlled discharge",sizeof(batteryCalibration.status)-1);
  } else {
    strncpy(batteryCalibration.status,"idle",sizeof(batteryCalibration.status)-1);
  }
  batteryLastSavedCharged_mWh=batteryStats.charged_mWh;
  batteryLastSavedDischarged_mWh=batteryStats.discharged_mWh;
  batteryStatsLastSaveMs=millis();
  uint32_t bestDate=0;
  for(uint8_t i=0;i<BAT_DAILY_SLOT_COUNT;i++){
    BatteryDailyRecord d={};
    if(!eepromReadBytes(BAT_DAILY_BASE+(uint16_t)i*BAT_DAILY_SLOT_SIZE,(uint8_t*)&d,sizeof(d)))continue;
    uint16_t c=crc16Data((const uint8_t*)&d,sizeof(d)-sizeof(d.crc));
    if(d.magic==BAT_DAILY_MAGIC && c==d.crc && d.date>=bestDate){bestDate=d.date;batteryDailySlot=i;}
  }
  if(batteryStatsDirty) batteryStatsSave(true);
}

void batteryStatsSave(bool force) {
  if(!eepromPresent || !batteryStatsDirty) return;
  uint64_t deltaC=batteryStats.charged_mWh-batteryLastSavedCharged_mWh;
  uint64_t deltaD=batteryStats.discharged_mWh-batteryLastSavedDischarged_mWh;
  if(!force && (uint32_t)(millis()-batteryStatsLastSaveMs)<BAT_STATS_SAVE_INTERVAL_MS &&
     deltaC<BAT_STATS_DIRTY_ENERGY_MWH && deltaD<BAT_STATS_DIRTY_ENERGY_MWH) return;
  batteryStats.magic=BAT_STATS_MAGIC; batteryStats.version=BAT_STATS_VERSION; batteryStats.size=sizeof(BatteryStatsPersist);
  batteryStats.calibrationActive=batteryCalibration.active?1:0;
  batteryStats.calibrationStartSoc=batteryCalibration.startSoc;
  batteryStats.calibrationEndSoc=batteryCalibration.endSoc;
  batteryStats.calibrationNetDischarge_mWh=batteryCalibration.netDischarge_mWh;
  batteryStats.sequence++;
  batteryStats.crc=crc16Data((const uint8_t*)&batteryStats,sizeof(BatteryStatsPersist)-sizeof(batteryStats.crc));
  uint8_t next=(uint8_t)((batteryStatsSlot+1)%BAT_STATS_SLOT_COUNT);
  if(eepromWriteBytes((uint16_t)next*BAT_STATS_SLOT_SIZE,(const uint8_t*)&batteryStats,sizeof(batteryStats))){
    batteryStatsSlot=next; batteryStatsDirty=false; batteryStatsLastSaveMs=millis();
    batteryLastSavedCharged_mWh=batteryStats.charged_mWh;
    batteryLastSavedDischarged_mWh=batteryStats.discharged_mWh;
  }
}

void appendDailyRecord(uint32_t date,uint64_t charged,uint64_t discharged,uint64_t discharged_mAh) {
  if(!eepromPresent || !date) return;
  BatteryDailyRecord d={}; d.magic=BAT_DAILY_MAGIC; d.date=date;
  d.charged_mWh=(uint32_t)min(charged,(uint64_t)0xFFFFFFFFULL);
  d.discharged_mWh=(uint32_t)min(discharged,(uint64_t)0xFFFFFFFFULL);
  d.discharged_mAh=(uint32_t)min(discharged_mAh,(uint64_t)0xFFFFFFFFULL);
  uint32_t ref=batteryReferenceCapacity_mAh();
  d.efc_milli=ref?(uint32_t)((discharged_mAh*1000ULL)/ref):0;
  d.crc=crc16Data((const uint8_t*)&d,sizeof(d)-sizeof(d.crc));
  batteryDailySlot=(uint8_t)((batteryDailySlot+1)%BAT_DAILY_SLOT_COUNT);
  eepromWriteBytes(BAT_DAILY_BASE+(uint16_t)batteryDailySlot*BAT_DAILY_SLOT_SIZE,(const uint8_t*)&d,sizeof(d));
}

void serviceBatteryDayRollover() {
  uint32_t today=rtcDateKey(); if(!today) return;
  if(!batteryStats.dayDate){batteryStats.dayDate=today;batteryStats.dayStartCharged_mWh=batteryStats.charged_mWh;batteryStats.dayStartDischarged_mWh=batteryStats.discharged_mWh;batteryStats.dayStartDischarged_mAh=batteryStats.discharged_mAh;if(!batteryStats.firstDate)batteryStats.firstDate=today;batteryStatsDirty=true;return;}
  if(today!=batteryStats.dayDate){
    uint64_t c=batteryStats.charged_mWh-batteryStats.dayStartCharged_mWh;
    uint64_t d=batteryStats.discharged_mWh-batteryStats.dayStartDischarged_mWh;
    uint64_t dAh=batteryStats.discharged_mAh-batteryStats.dayStartDischarged_mAh;
    appendDailyRecord(batteryStats.dayDate,c,d,dAh);
    batteryStats.dayDate=today; batteryStats.dayStartCharged_mWh=batteryStats.charged_mWh; batteryStats.dayStartDischarged_mWh=batteryStats.discharged_mWh; batteryStats.dayStartDischarged_mAh=batteryStats.discharged_mAh;
    batteryStatsDirty=true; batteryStatsSave(true);
  }
}

void serviceBatteryStats() {
  serviceBatteryDayRollover();
  uint32_t stamp=telemetryUpdatedMs;
  if(!stamp || stamp==batteryStatsLastTelemetryStamp) { batteryStatsSave(false); return; }
  uint32_t dtMs=batteryStatsLastTelemetryStamp ? (uint32_t)(stamp-batteryStatsLastTelemetryStamp) : 0;
  batteryStatsLastTelemetryStamp=stamp;
  if(!dtMs || dtMs>15000) { batteryStatsSave(false); return; }
  if(!haveReg(215) || (!haveReg(232) && !haveReg(216))) { batteryStatsSave(false); return; }
  float v=regScaled(215,10,false);
  float rawA=haveReg(232)?regScaled(232,10,true):regScaled(216,10,true);
  float soc=haveReg(229)?regScaled(229,1,false):NAN;
  if(isnan(v)||isnan(rawA)||v<10||v>70) return;
  // Measured zero is approximately -1.4 A, therefore I(real) = I(reg232) + 1.4 A.
  // Apply the existing 0.20 A deadband after offset correction.
  float a=rawA + BAT_STATS_CURRENT_OFFSET_A;
  if(fabsf(a)<=BAT_CURRENT_DEADBAND_A) a=0.0f;
  batteryStatsRawCurrentA=rawA;
  batteryStatsCountedCurrentA=a;
  double p=(double)v*(double)a;
  double mWh=fabs(p)*(double)dtMs/3600.0;
  double mAh=fabs((double)a)*(double)dtMs/3600.0;
  if(a>BAT_CURRENT_DEADBAND_A){
    batteryChargeFrac_mWh+=mWh; uint64_t whole=(uint64_t)batteryChargeFrac_mWh;
    if(whole){batteryStats.charged_mWh+=whole;batteryChargeFrac_mWh-=whole;batteryStatsDirty=true;}
    batteryChargeFrac_mAh+=mAh; uint64_t wholeAh=(uint64_t)batteryChargeFrac_mAh;
    if(wholeAh){batteryStats.charged_mAh+=wholeAh;batteryChargeFrac_mAh-=wholeAh;batteryStatsDirty=true;}
    batteryStats.chargeSeconds+=dtMs/1000;
    int32_t ma=(int32_t)lround(a*1000.0f);if(ma>batteryStats.maxCharge_mA){batteryStats.maxCharge_mA=ma;batteryStatsDirty=true;}
    if(batteryCalibration.active) batteryCalibration.netDischarge_mWh-= (int64_t)whole;
  } else if(a<-BAT_CURRENT_DEADBAND_A){
    batteryDischargeFrac_mWh+=mWh; uint64_t whole=(uint64_t)batteryDischargeFrac_mWh;
    if(whole){batteryStats.discharged_mWh+=whole;batteryDischargeFrac_mWh-=whole;batteryStatsDirty=true;}
    batteryDischargeFrac_mAh+=mAh; uint64_t wholeAh=(uint64_t)batteryDischargeFrac_mAh;
    if(wholeAh){batteryStats.discharged_mAh+=wholeAh;batteryDischargeFrac_mAh-=wholeAh;batteryStatsDirty=true;}
    batteryStats.dischargeSeconds+=dtMs/1000;
    int32_t ma=(int32_t)lround((-a)*1000.0f);if(ma>batteryStats.maxDischarge_mA){batteryStats.maxDischarge_mA=ma;batteryStatsDirty=true;}
    if(batteryCalibration.active) batteryCalibration.netDischarge_mWh+= (int64_t)whole;
  }
  if(batteryCalibration.netDischarge_mWh<0) batteryCalibration.netDischarge_mWh=0;

  if(!isnan(soc)){
    uint8_t si=(uint8_t)constrain((int)lround(soc),0,100);
    // When the target SOC is reached, stop forced battery operation by restoring
    // register 301 to the value that was present before calibration.  Calibration
    // remains active until the user presses Finish, so the measured segment can be reviewed.
    if(batteryCalibration.active && !batteryCalibration.targetReached && !batteryCalibration.restoreQueued &&
       si<=batteryCalibration.endSoc){
      batteryCalibration.targetReached=true;
      if(batteryCalibration.previousOutputPriorityValid && rtuJobQueue){
        RtuJob stopJob={}; stopJob.type=RTU_JOB_CAL_RESTORE; stopJob.id=rtuNextJobId++;
        stopJob.reg=301; stopJob.raw=batteryCalibration.previousOutputPriority;
        if(xQueueSend(rtuJobQueue,&stopJob,0)==pdTRUE){
          batteryCalibration.restoreQueued=true;
          snprintf(batteryCalibration.status,sizeof(batteryCalibration.status),"target %u%% reached; restoring output priority",batteryCalibration.endSoc);
        } else {
          snprintf(batteryCalibration.status,sizeof(batteryCalibration.status),"target reached; RTU queue full - stop discharge manually");
        }
      } else {
        snprintf(batteryCalibration.status,sizeof(batteryCalibration.status),"target reached; stop discharge manually");
      }
      batteryStatsDirty=true; batteryStatsSave(true);
    }
  }
  batteryStatsSave(false);
}

void handleBatteryStatsGet(){
  uint64_t todayC=(batteryStats.charged_mWh>=batteryStats.dayStartCharged_mWh)
    ? batteryStats.charged_mWh-batteryStats.dayStartCharged_mWh : batteryStats.charged_mWh;
  uint64_t todayD=(batteryStats.discharged_mWh>=batteryStats.dayStartDischarged_mWh)
    ? batteryStats.discharged_mWh-batteryStats.dayStartDischarged_mWh : batteryStats.discharged_mWh;
  uint32_t ref=batteryReferenceEnergy_mWh();
  String j; j.reserve(2600); j=F("{\"ok\":true");
  j+=F(",\"eeprom_present\":");j+=eepromPresent?F("true"):F("false");
  j+=F(",\"eeprom_addr\":");if(eepromPresent)j+=eepromI2cAddr;else j+=F("null");
  j+=F(",\"charged_kwh\":");j+=String((double)batteryStats.charged_mWh/1000000.0,3);
  j+=F(",\"discharged_kwh\":");j+=String((double)batteryStats.discharged_mWh/1000000.0,3);
  j+=F(",\"efc\":");j+=String(batteryEfc(),3);
  j+=F(",\"charged_ah\":");j+=String((double)batteryStats.charged_mAh/1000.0,2);
  j+=F(",\"discharged_ah\":");j+=String((double)batteryStats.discharged_mAh/1000.0,2);
  j+=F(",\"raw_battery_current_a\":");if(isnan(batteryStatsRawCurrentA))j+=F("null");else j+=String(batteryStatsRawCurrentA,1);
  j+=F(",\"stats_battery_current_a\":");if(isnan(batteryStatsCountedCurrentA))j+=F("null");else j+=String(batteryStatsCountedCurrentA,1);
  j+=F(",\"stats_current_offset_a\":");j+=String(BAT_STATS_CURRENT_OFFSET_A,1);
  j+=F(",\"reference_capacity_ah\":");j+=String(profileNominalCapacity_mAh()/1000.0f,1);
  j+=F(",\"capacity_source\":\"profile\"");
  j+=F(",\"reference_energy_kwh\":");j+=String(ref/1000000.0f,3);
  j+=F(",\"calibrated_energy_kwh\":");if(batteryStats.calibratedEnergy_mWh)j+=String(batteryStats.calibratedEnergy_mWh/1000000.0f,3);else j+=F("null");
  j+=F(",\"calibrated_capacity_ah\":");if(batteryStats.calibratedEnergy_mWh)j+=String(calibratedCapacity_mAh()/1000.0f,1);else j+=F("null");
  j+=F(",\"calibrated_capacity_valid\":");j+=calibratedCapacityPlausible()?F("true"):F("false");
  j+=F(",\"charge_hours\":");j+=String(batteryStats.chargeSeconds/3600.0f,1);
  j+=F(",\"discharge_hours\":");j+=String(batteryStats.dischargeSeconds/3600.0f,1);
  j+=F(",\"max_charge_a\":");j+=String(batteryStats.maxCharge_mA/1000.0f,1);
  j+=F(",\"max_discharge_a\":");j+=String(batteryStats.maxDischarge_mA/1000.0f,1);
  j+=F(",\"today_charged_kwh\":");j+=String((double)todayC/1000000.0,3);
  j+=F(",\"today_discharged_kwh\":");j+=String((double)todayD/1000000.0,3);
  j+=F(",\"first_date\":");j+=batteryStats.firstDate;
  j+=F(",\"calibration\":{\"active\":");j+=batteryCalibration.active?F("true"):F("false");
  j+=F(",\"start_soc\":");j+=batteryCalibration.startSoc;
  j+=F(",\"end_soc\":");j+=batteryCalibration.endSoc;
  j+=F(",\"net_discharge_kwh\":");j+=String((double)batteryCalibration.netDischarge_mWh/1000000.0,3);
  double calNetAh=0.0;
  if(batteryCalibration.active){
    int64_t dd=(int64_t)batteryStats.discharged_mAh-(int64_t)batteryCalibration.startDischarged_mAh;
    int64_t cc=(int64_t)batteryStats.charged_mAh-(int64_t)batteryCalibration.startCharged_mAh;
    int64_t net=dd-cc; if(net<0)net=0; calNetAh=(double)net/1000.0;
  }
  j+=F(",\"net_discharge_ah\":");j+=String(calNetAh,2);
  j+=F(",\"current_soc\":");if(haveReg(229))j+=String(regScaled(229,1,false),0);else j+=F("null");
  j+=F(",\"target_reached\":");j+=batteryCalibration.targetReached?F("true"):F("false");
  j+=F(",\"auto_discharge\":true");
  j+=F(",\"previous_priority\":");if(batteryCalibration.previousOutputPriorityValid)j+=batteryCalibration.previousOutputPriority;else j+=F("null");
  j+=F(",\"elapsed_sec\":");j+=batteryCalibration.active?((millis()-batteryCalibration.startedMs)/1000UL):0;
  j+=F(",\"status\":\"");j+=jsonEscape(String(batteryCalibration.status));j+=F("\"}");
  j+=F(",\"history\":[");
  bool first=true;
  if(eepromPresent){
    for(uint8_t n=0;n<BAT_DAILY_SLOT_COUNT;n++){
      int idx=(int)batteryDailySlot-(int)n;while(idx<0)idx+=BAT_DAILY_SLOT_COUNT;
      BatteryDailyRecord d={};if(!eepromReadBytes(BAT_DAILY_BASE+(uint16_t)idx*BAT_DAILY_SLOT_SIZE,(uint8_t*)&d,sizeof(d)))continue;
      uint16_t c=crc16Data((const uint8_t*)&d,sizeof(d)-sizeof(d.crc));if(d.magic!=BAT_DAILY_MAGIC||c!=d.crc||!d.date)continue;
      if(!first)j+=',';first=false;
      j+=F("{\"date\":");j+=d.date;j+=F(",\"charged_kwh\":");j+=String(d.charged_mWh/1000000.0f,3);
      j+=F(",\"discharged_kwh\":");j+=String(d.discharged_mWh/1000000.0f,3);j+=F(",\"discharged_ah\":");j+=String(d.discharged_mAh/1000.0f,2);j+=F(",\"efc\":");j+=String(d.efc_milli/1000.0f,3);j+='}';
      if(n>=29)break;
    }
  }
  j+=F("]}");sendJson(200,j);
}

void handleBatteryCalibrationStart(){
  if(!adminAuthorized()){sendJson(401,F("{\"ok\":false,\"error\":\"Admin authorization required\"}"));return;}
  if(!rtuJobQueue){sendJson(503,F("{\"ok\":false,\"error\":\"RTU worker unavailable\"}"));return;}
  if(batteryCalibration.active){sendJson(409,F("{\"ok\":false,\"error\":\"Calibration already active\"}"));return;}
  if(!haveReg(229)){sendJson(409,F("{\"ok\":false,\"error\":\"Battery SOC unavailable\"}"));return;}
  int soc=(int)lround(regScaled(229,1,false));
  String body=web.arg("plain");double endD=20;jsonFindNumber(body,"end_soc",endD);
  if(soc<90){sendJson(409,F("{\"ok\":false,\"error\":\"Start controlled discharge near full battery (SOC >= 90%)\"}"));return;}
  if(endD<10||endD>50||soc<=endD+10){sendJson(400,F("{\"ok\":false,\"error\":\"Invalid end_soc\"}"));return;}
  if(webWriteBusReserved || uxQueueMessagesWaiting(rtuJobQueue)>=5){sendJson(409,F("{\"ok\":false,\"error\":\"RTU is busy\"}"));return;}

  RtuJob job={}; job.type=RTU_JOB_CAL_START; job.id=rtuNextJobId++; if(!job.id)job.id=rtuNextJobId++;
  job.reg=301; job.raw=2; job.addr=(uint16_t)soc; job.count=(uint16_t)endD;
  webWriteBusReserved=true;
  portENTER_CRITICAL(&webWriteResultMux);
  webWriteResult.id=job.id; webWriteResult.done=false; webWriteResult.ok=false; webWriteResult.verified=false;
  webWriteResult.reg=301; webWriteResult.oldRaw=0; webWriteResult.newRaw=0; webWriteResult.error[0]=0;
  portEXIT_CRITICAL(&webWriteResultMux);
  if(xQueueSend(rtuJobQueue,&job,0)!=pdTRUE){webWriteBusReserved=false;sendJson(503,F("{\"ok\":false,\"error\":\"RTU queue full\"}"));return;}
  String j=F("{\"ok\":true,\"queued\":true,\"job_id\":");j+=job.id;j+=F(",\"register\":301,\"value\":2}");sendJson(202,j);
}

bool queueCalibrationRestore(){
  if(!batteryCalibration.previousOutputPriorityValid || !rtuJobQueue || batteryCalibration.restoreQueued || batteryCalibration.outputRestored) return false;
  RtuJob job={};job.type=RTU_JOB_CAL_RESTORE;job.id=rtuNextJobId++;job.reg=301;job.raw=batteryCalibration.previousOutputPriority;
  if(xQueueSend(rtuJobQueue,&job,0)!=pdTRUE)return false;
  batteryCalibration.restoreQueued=true; return true;
}

void handleBatteryCalibrationFinish(){
  if(!adminAuthorized()){sendJson(401,F("{\"ok\":false,\"error\":\"Admin authorization required\"}"));return;}
  if(!batteryCalibration.active){sendJson(409,F("{\"ok\":false,\"error\":\"Calibration is not active\"}"));return;}
  if(!haveReg(229)){sendJson(409,F("{\"ok\":false,\"error\":\"Battery SOC unavailable\"}"));return;}
  int endSoc=(int)lround(regScaled(229,1,false));
  int delta=(int)batteryCalibration.startSoc-endSoc;
  int64_t dd=(int64_t)batteryStats.discharged_mAh-(int64_t)batteryCalibration.startDischarged_mAh;
  int64_t cc=(int64_t)batteryStats.charged_mAh-(int64_t)batteryCalibration.startCharged_mAh;
  int64_t netmAh=dd-cc; if(netmAh<0)netmAh=0;
  if(delta<10){sendJson(409,F("{\"ok\":false,\"error\":\"SOC range is too small; discharge at least 10% before finishing\"}"));return;}
  if(netmAh<1000){sendJson(409,F("{\"ok\":false,\"error\":\"Measured discharge is too small\"}"));return;}

  const double measuredAh=(double)netmAh/1000.0;
  const double nominalAh=(double)profileNominalCapacity_mAh()/1000.0;
  const double socEstimateAh=measuredAh*100.0/(double)delta;
  // Inverter SOC on LiFePO4 can be very coarse. Never overwrite capacity from a
  // short SOC span or from an estimate that is implausible for the active profile.
  const bool socSpanGood=(delta>=60);
  const bool estimatePlausible=(nominalAh>0.0 && socEstimateAh>=nominalAh*0.60 && socEstimateAh<=nominalAh*1.40);
  const bool saveEstimate=socSpanGood && estimatePlausible;

  if(saveEstimate){
    const double fullWh=socEstimateAh*profileNominalVoltage();
    batteryStats.calibratedEnergy_mWh=(uint32_t)lround(fullWh*1000.0);
    snprintf(batteryCalibration.status,sizeof(batteryCalibration.status),
             "complete: %.1f Ah, SOC span %d%%",socEstimateAh,delta);
  }else{
    snprintf(batteryCalibration.status,sizeof(batteryCalibration.status),
             "measurement complete: %.1f Ah; SOC estimate rejected (%d%% span)",measuredAh,delta);
  }
  bool restoreQueued=queueCalibrationRestore();
  batteryCalibration.active=false;
  batteryStatsDirty=true;batteryStatsSave(true);

  String j=F("{\"ok\":true,\"saved\":");j+=saveEstimate?F("true"):F("false");
  j+=F(",\"capacity_ah\":");j+=String(socEstimateAh,1);
  j+=F(",\"nominal_capacity_ah\":");j+=String(nominalAh,1);
  j+=F(",\"start_soc\":");j+=batteryCalibration.startSoc;
  j+=F(",\"end_soc\":");j+=endSoc;
  j+=F(",\"soc_span\":");j+=delta;
  j+=F(",\"net_discharge_ah\":");j+=String(measuredAh,2);
  j+=F(",\"restore_queued\":");j+=restoreQueued?F("true"):F("false");
  j+=F(",\"warning\":\"");
  if(!saveEstimate){
    if(!socSpanGood) j+=F("SOC span below 60%; inverter SOC is too coarse for capacity extrapolation");
    else j+=F("SOC-derived capacity is implausible for active battery profile");
  }
  j+=F("\"}");sendJson(200,j);
}

void handleBatteryCalibrationCancel(){
  if(!adminAuthorized()){sendJson(401,F("{\"ok\":false,\"error\":\"Admin authorization required\"}"));return;}
  bool restoreQueued=queueCalibrationRestore();
  batteryCalibration.active=false;strncpy(batteryCalibration.status,"cancelled",sizeof(batteryCalibration.status)-1);
  batteryStatsDirty=true;batteryStatsSave(true);
  String j=F("{\"ok\":true,\"restore_queued\":");j+=restoreQueued?F("true"):F("false");j+='}';sendJson(200,j);
}

void handleBatteryCalibrationManual(){
  if(!adminAuthorized()){sendJson(401,F("{\"ok\":false,\"error\":\"Admin authorization required\"}"));return;}
  String body=web.arg("plain");double ah=0;if(!jsonFindNumber(body,"capacity_ah",ah)||ah<10||ah>1000){sendJson(400,F("{\"ok\":false,\"error\":\"capacity_ah 10..1000 required\"}"));return;}
  double wh=ah*profileNominalVoltage();batteryStats.calibratedEnergy_mWh=(uint32_t)lround(wh*1000.0);batteryStatsDirty=true;batteryStatsSave(true);sendJson(200,F("{\"ok\":true}"));
}

bool eraseBatteryStatsEeprom() {
  if(!eepromPresent) return false;
  const uint16_t endAddr=BAT_DAILY_BASE+(uint16_t)BAT_DAILY_SLOT_COUNT*BAT_DAILY_SLOT_SIZE;
  uint8_t blank[32]; memset(blank,0xFF,sizeof(blank));
  for(uint16_t a=0;a<endAddr;a+=sizeof(blank)){
    size_t n=min((size_t)sizeof(blank),(size_t)(endAddr-a));
    if(!eepromWriteBytes(a,blank,n)) return false;
  }
  // Verify all statistics slots. A stale valid slot must never resurrect after reboot.
  for(uint8_t i=0;i<BAT_STATS_SLOT_COUNT;i++){
    BatteryStatsPersist r={};
    if(!eepromReadBytes((uint16_t)i*BAT_STATS_SLOT_SIZE,(uint8_t*)&r,sizeof(r))) return false;
    if(batteryStatsRecordValid(r)) return false;
  }
  // Verify that daily history no longer contains a valid record either.
  for(uint8_t i=0;i<BAT_DAILY_SLOT_COUNT;i++){
    BatteryDailyRecord d={};
    if(!eepromReadBytes(BAT_DAILY_BASE+(uint16_t)i*BAT_DAILY_SLOT_SIZE,(uint8_t*)&d,sizeof(d))) return false;
    uint16_t c=crc16Data((const uint8_t*)&d,sizeof(d)-sizeof(d.crc));
    if(d.magic==BAT_DAILY_MAGIC && c==d.crc) return false;
  }
  return true;
}

void handleBatteryStatsReset(){
  if(!adminAuthorized()){sendJson(401,F("{\"ok\":false,\"error\":\"Admin authorization required\"}"));return;}
  String body=web.arg("plain");
  String confirm, mode;
  if(!jsonFindString(body,"confirm",confirm) || confirm!="RESET"){
    sendJson(400,F("{\"ok\":false,\"error\":\"confirm RESET required\"}")); return;
  }
  if(!jsonFindString(body,"mode",mode) || (mode!="stats" && mode!="all")){
    sendJson(400,F("{\"ok\":false,\"error\":\"mode must be stats or all\"}")); return;
  }

  const bool keepCalibration=(mode=="stats");
  const uint32_t savedCalibration=keepCalibration?batteryStats.calibratedEnergy_mWh:0;
  bool storageErased=true;
  if(eepromPresent) storageErased=eraseBatteryStatsEeprom();

  batteryCalibration.active=false;
  batteryCalibration.startSoc=0; batteryCalibration.endSoc=20;
  batteryCalibration.netDischarge_mWh=0; batteryCalibration.startedMs=0;
  memset(batteryCalibration.status,0,sizeof(batteryCalibration.status));

  batteryStatsDefaults();
  batteryStats.sequence=0;
  batteryStatsSlot=BAT_STATS_SLOT_COUNT-1; // first new write goes to slot 0
  batteryStats.calibratedEnergy_mWh=savedCalibration;
  batteryStatsDirty=true;
  batteryChargeFrac_mWh=0; batteryDischargeFrac_mWh=0;
  batteryChargeFrac_mAh=0; batteryDischargeFrac_mAh=0;
  batteryStatsLastTelemetryStamp=telemetryUpdatedMs;
  batteryLastSavedCharged_mWh=0; batteryLastSavedDischarged_mWh=0;
  batteryDailySlot=0;

  bool persisted=false;
  if(eepromPresent && storageErased){
    batteryStatsSave(true);
    persisted=!batteryStatsDirty;
  }

  // Reset must always take effect in RAM. EEPROM persistence is reported
  // separately so a missing/faulty AT24C32 cannot make the UI look unchanged.
  String r=F("{\"ok\":true,\"reset\":true,\"mode\":\""); r+=mode;
  r+=F("\",\"eeprom_present\":"); r+=eepromPresent?F("true"):F("false");
  r+=F(",\"storage_erased\":"); r+=storageErased?F("true"):F("false");
  r+=F(",\"persisted\":"); r+=persisted?F("true"):F("false");
  r+=F(",\"calibration_kept\":"); r+=keepCalibration?F("true"):F("false");
  r+=F(",\"charged_kwh\":0,\"discharged_kwh\":0,\"charged_ah\":0,\"discharged_ah\":0,\"efc\":0}");
  sendJson(200,r);
}

void loadScheduleTasks() {
  schedPrefs.begin("scheduler", false);
  for (uint8_t i=0; i<SCHEDULE_TASK_COUNT; ++i) {
    char k[8];
    snprintf(k,sizeof(k),"e%u",i); scheduleTasks[i].enabled=schedPrefs.getBool(k,false);
    snprintf(k,sizeof(k),"d%u",i); scheduleTasks[i].daysMask=(uint8_t)schedPrefs.getUChar(k,127);
    snprintf(k,sizeof(k),"h%u",i); scheduleTasks[i].hour=(uint8_t)schedPrefs.getUChar(k,0);
    snprintf(k,sizeof(k),"m%u",i); scheduleTasks[i].minute=(uint8_t)schedPrefs.getUChar(k,0);
    snprintf(k,sizeof(k),"r%u",i); scheduleTasks[i].reg=(uint16_t)schedPrefs.getUShort(k,301);
    snprintf(k,sizeof(k),"v%u",i); scheduleTasks[i].raw=(uint16_t)schedPrefs.getUShort(k,1);
    if (scheduleTasks[i].daysMask == 0 || scheduleTasks[i].hour > 23 ||
        scheduleTasks[i].minute > 59) scheduleTasks[i].enabled=false;
  }
}

void saveScheduleTask(uint8_t i) {
  if (i >= SCHEDULE_TASK_COUNT) return;
  char k[8];
  snprintf(k,sizeof(k),"e%u",i); schedPrefs.putBool(k,scheduleTasks[i].enabled);
  snprintf(k,sizeof(k),"d%u",i); schedPrefs.putUChar(k,scheduleTasks[i].daysMask);
  snprintf(k,sizeof(k),"h%u",i); schedPrefs.putUChar(k,scheduleTasks[i].hour);
  snprintf(k,sizeof(k),"m%u",i); schedPrefs.putUChar(k,scheduleTasks[i].minute);
  snprintf(k,sizeof(k),"r%u",i); schedPrefs.putUShort(k,scheduleTasks[i].reg);
  snprintf(k,sizeof(k),"v%u",i); schedPrefs.putUShort(k,scheduleTasks[i].raw);
}

bool executeScheduleTask(uint8_t i) {
  if (i >= SCHEDULE_TASK_COUNT || !rtuJobQueue) return false;
  ScheduleTask &t = scheduleTasks[i];
  String err;
  if (!validateRaw(t.reg, t.raw, err)) {
    schedulerErrors++;
    schedulerLast = String("Task ") + (i+1) + ": " + err;
    return false;
  }

  RtuJob job = {};
  job.type = RTU_JOB_SCHEDULE;
  job.id = rtuNextJobId++;
  job.reg = t.reg;
  job.raw = t.raw;
  job.scheduleSlot = i;
  if (xQueueSend(rtuJobQueue, &job, 0) != pdTRUE) {
    schedulerErrors++;
    schedulerLast = String("Task ") + (i+1) + ": RTU queue full";
    return false;
  }
  schedulerLast = String("Task ") + (i+1) + ": queued";
  return true;
}

int64_t civilDaysFromEpoch(int y, unsigned m, unsigned d) {
  y -= m <= 2;
  const int era = (y >= 0 ? y : y-399) / 400;
  const unsigned yoe = (unsigned)(y - era * 400);
  const unsigned doy = (153*(m + (m > 2 ? -3 : 9)) + 2)/5 + d-1;
  const unsigned doe = yoe * 365 + yoe/4 - yoe/100 + doy;
  return (int64_t)era * 146097 + (int64_t)doe - 719468;
}

int64_t rtcCivilSeconds(const RtcDateTime& d) {
  return civilDaysFromEpoch(d.year,d.month,d.day)*86400LL + (int64_t)d.hour*3600LL + (int64_t)d.minute*60LL + d.second;
}

bool clockDateTimeValid(const RtcDateTime& d) {
  return d.valid && d.year>=2024 && d.year<=2099 && d.month>=1 && d.month<=12 &&
         d.day>=1 && d.day<=31 && d.hour<=23 && d.minute<=59 && d.second<=59;
}

const char* clockSourceName() {
  switch(clockSource){
    case CLOCK_RTC: return "rtc";
    case CLOCK_NTP: return "ntp";
    case CLOCK_BROWSER: return "browser";
    default: return "none";
  }
}

void clockCache(const RtcDateTime& dt, ClockSource source) {
  if(!clockDateTimeValid(dt)) return;
  rtcCached=dt;
  rtcCachedAtMs=millis();
  clockCachedAtUs=(uint64_t)esp_timer_get_time();
  clockSource=source;
}

bool clockNow(RtcDateTime& out) {
  if(!clockDateTimeValid(rtcCached) || !clockCachedAtUs) { out.valid=false; return false; }
  uint64_t elapsed=(uint64_t)(esp_timer_get_time()-clockCachedAtUs)/1000000ULL;
  uint64_t tod=(uint64_t)rtcCached.hour*3600ULL+(uint64_t)rtcCached.minute*60ULL+rtcCached.second+elapsed;
  uint32_t days=(uint32_t)(tod/86400ULL);
  uint32_t rem=(uint32_t)(tod%86400ULL);
  out=rtcCached;
  out.hour=(uint8_t)(rem/3600U); rem%=3600U;
  out.minute=(uint8_t)(rem/60U); out.second=(uint8_t)(rem%60U);
  while(days--){
    static const uint8_t mdays[]={31,28,31,30,31,30,31,31,30,31,30,31};
    uint8_t dim=mdays[out.month-1];
    bool leap=(out.year%4==0 && (out.year%100!=0 || out.year%400==0));
    if(out.month==2 && leap) dim=29;
    if(++out.day>dim){out.day=1;if(++out.month>12){out.month=1;out.year++;}}
    if(out.year>2099){out.valid=false;return false;}
  }
  out.valid=true;
  return true;
}

bool ntpLocalDateTime(RtcDateTime& out) {
  struct tm tmNow;
  if (!getLocalTime(&tmNow, 50)) return false;
  int y=tmNow.tm_year+1900;
  if (y < 2024 || y > 2099) return false;
  out={(uint16_t)y,(uint8_t)(tmNow.tm_mon+1),(uint8_t)tmNow.tm_mday,(uint8_t)tmNow.tm_hour,(uint8_t)tmNow.tm_min,(uint8_t)tmNow.tm_sec,true};
  return true;
}

void serviceNtpRtcSync() {
  if (setupMode || WiFi.status()!=WL_CONNECTED) return;
  uint32_t now=millis();
  if (!ntpConfigured) {
    // Fixed UTC offset only; no DST/seasonal conversion. The logical clock uses local civil time.
    configTime((long)ntpUtcOffsetMin * 60L, 0, ntpServer.c_str(), NTP_FALLBACK_SERVER);
    ntpConfigured=true;
    ntpLastAttemptMs=0; // allow the first sync immediately after Wi-Fi/NTP setup
    Serial.println(F("[NTP] client configured"));
  }
  bool due=!ntpEverSynced || (uint32_t)(now-ntpLastSyncMs)>=NTP_RESYNC_MS;
  if (!due) return;
  uint32_t retryMs=ntpEverSynced?NTP_RETRY_MS:NTP_INITIAL_RETRY_MS;
  if (ntpLastAttemptMs && (uint32_t)(now-ntpLastAttemptMs)<retryMs) return;
  ntpLastAttemptMs=now;
  RtcDateTime ndt;
  if (!ntpLocalDateTime(ndt)) return;
  RtcDateTime old;
  if (clockNow(old)) ntpLastCorrectionSec=(int32_t)(rtcCivilSeconds(ndt)-rtcCivilSeconds(old)); else ntpLastCorrectionSec=0;
  clockCache(ndt,CLOCK_NTP);
  bool rtcStored=false;
  if(rtcPresent){
    rtcStored=rtcWrite(ndt);
    if(!rtcStored) rtcPresent=false;
  }
  schedulerLastMinuteKey=0xFFFFFFFFUL;
  ntpEverSynced=true; ntpLastSyncMs=now;
  Serial.print(F("[NTP] clock synchronized; correction s=")); Serial.print(ntpLastCorrectionSec);
  Serial.print(F("; RTC persisted=")); Serial.println(rtcStored?F("yes"):F("no"));
}

void serviceScheduler() {
  static uint32_t lastCheckMs=0;
  static uint32_t lastRtcProbeMs=0;
  if (setupMode || (uint32_t)(millis()-lastCheckMs) < 1000) return;
  lastCheckMs=millis();

  bool probeRtc=rtcPresent || !lastRtcProbeMs || (uint32_t)(millis()-lastRtcProbeMs)>=60000UL;
  if(probeRtc){
    lastRtcProbeMs=millis();
    RtcDateTime hw={0,0,0,0,0,0,false};
    bool busOk=rtcRead(hw);
    rtcPresent=busOk;
    if(busOk && hw.valid) clockCache(hw,CLOCK_RTC);
  }

  RtcDateTime dt;
  if (!clockNow(dt)) return;

  uint32_t dayKey=(uint32_t)dt.year*10000UL+(uint32_t)dt.month*100UL+dt.day;
  uint32_t minuteKey=(dayKey*1440UL)+(uint32_t)dt.hour*60UL+dt.minute;
  if (minuteKey == schedulerLastMinuteKey) return;
  schedulerLastMinuteKey = minuteKey;

  uint8_t wd=weekdayMon0(dt.year,dt.month,dt.day);
  uint8_t bit=(uint8_t)(1U<<wd);
  for (uint8_t i=0;i<SCHEDULE_TASK_COUNT;++i) {
    const ScheduleTask &t=scheduleTasks[i];
    if (!t.enabled || !(t.daysMask & bit)) continue;
    if (t.hour==dt.hour && t.minute==dt.minute) executeScheduleTask(i);
  }
}

void handleRtcGet() {
  RtcDateTime dt={0,0,0,0,0,0,false};
  bool timeOk=clockNow(dt);
  String j=F("{\"ok\":true,\"present\":");
  j+=rtcPresent?F("true"):F("false");
  j+=F(",\"valid\":"); j+=timeOk?F("true"):F("false");
  j+=F(",\"type\":\""); j+=rtcPresent?F("DS1307/compatible"):F("software"); j+=F("\"");
  j+=F(",\"source\":\""); j+=clockSourceName(); j+=F("\"");
  j+=F(",\"persistent_clock\":"); j+=rtcPresent?F("true"):F("false");
  j+=F(",\"eeprom_present\":"); j+=eepromPresent?F("true"):F("false");
  j+=F(",\"persistent_stats\":"); j+=eepromPresent?F("true"):F("false");
  j+=F(",\"eeprom_addr\":"); if(eepromPresent) j+=eepromI2cAddr; else j+=F("null");
  j+=F(",\"time\":\""); if(timeOk)j+=rtcIso(dt); j+=F("\"");
  j+=F(",\"cache_age_ms\":"); if(clockCachedAtUs)j+=(uint32_t)((esp_timer_get_time()-clockCachedAtUs)/1000ULL);else j+=F("null");
  j+=F(",\"ntp_server\":\""); j+=jsonEscape(ntpServer); j+=F("\"");
  j+=F(",\"ntp_utc_offset_min\":"); j+=ntpUtcOffsetMin;
  j+=F(",\"ntp_synced\":"); j+=ntpEverSynced?F("true"):F("false");
  j+=F(",\"ntp_last_correction_s\":"); j+=ntpLastCorrectionSec;
  j+=F(",\"ntp_sync_age_s\":"); if(ntpEverSynced) j+=(millis()-ntpLastSyncMs)/1000UL; else j+=F("null");
  j+=F(",\"runs\":");j+=schedulerRuns;
  j+=F(",\"errors\":");j+=schedulerErrors;
  j+=F(",\"last\":\"");j+=jsonEscape(schedulerLast);j+=F("\"}");
  sendJson(200,j);
}

void handleRtcSet() {
  if (!adminAuthorized()) { sendJson(401,F("{\"ok\":false,\"error\":\"Admin authorization required\"}")); return; }
  String body=web.arg("plain");
  double y,mo,d,h,mi,se;
  if (!jsonFindNumber(body,"year",y)||!jsonFindNumber(body,"month",mo)||!jsonFindNumber(body,"day",d)||
      !jsonFindNumber(body,"hour",h)||!jsonFindNumber(body,"minute",mi)||!jsonFindNumber(body,"second",se)) {
    sendJson(400,F("{\"ok\":false,\"error\":\"year/month/day/hour/minute/second required\"}")); return;
  }
  RtcDateTime dt={(uint16_t)y,(uint8_t)mo,(uint8_t)d,(uint8_t)h,(uint8_t)mi,(uint8_t)se,true};
  if(!clockDateTimeValid(dt)){sendJson(400,F("{\"ok\":false,\"error\":\"invalid date/time\"}"));return;}
  clockCache(dt,CLOCK_BROWSER);
  bool rtcStored=false;
  if(rtcPresent){rtcStored=rtcWrite(dt);if(!rtcStored)rtcPresent=false;}
  schedulerLastMinuteKey=0xFFFFFFFFUL;
  String j=F("{\"ok\":true,\"saved\":true,\"source\":\"browser\",\"rtc_persisted\":");j+=rtcStored?F("true"):F("false");j+='}';sendJson(200,j);
}

void handleNtpConfigSet() {
  if(!adminAuthorized()){sendJson(401,F("{\"ok\":false,\"error\":\"Admin authorization required\"}"));return;}
  String body=web.arg("plain"), server; double offMin=ntpUtcOffsetMin;
  if(!jsonFindString(body,"server",server)){sendJson(400,F("{\"ok\":false,\"error\":\"server required\"}"));return;}
  jsonFindNumber(body,"utc_offset_min",offMin);
  server.trim();
  if(server.length()<3 || server.length()>63 || server.indexOf(' ')>=0){sendJson(400,F("{\"ok\":false,\"error\":\"invalid NTP server\"}"));return;}
  if(offMin < -720 || offMin > 840){sendJson(400,F("{\"ok\":false,\"error\":\"UTC offset must be -12:00..+14:00\"}"));return;}
  ntpServer=server; ntpUtcOffsetMin=(int16_t)lround(offMin);
  appPrefs.putString("ntp_server",ntpServer); appPrefs.putInt("ntp_utc_min",ntpUtcOffsetMin);
  ntpConfigured=false; ntpEverSynced=false; ntpLastAttemptMs=0;
  String j=String("{\"ok\":true,\"server\":\"")+jsonEscape(ntpServer)+"\",\"utc_offset_min\":"+String(ntpUtcOffsetMin)+"}"; sendJson(200,j);
}

void handleHallGet() {
  String j=F("{\"ok\":true");
  j+=F(",\"enabled\":"); j+=hallEnabled?F("true"):F("false");
  j+=F(",\"online\":"); j+=hallOnline?F("true"):F("false");
  j+=F(",\"address\":"); j+=hallAdsAddress;
  j+=F(",\"resolved_address\":"); if(hallResolvedAddress)j+=hallResolvedAddress;else j+=F("null");
  j+=F(",\"channel\":"); j+=hallChannel;
  j+=F(",\"zero_mv\":"); j+=String(hallZeroMv,3);
  j+=F(",\"sensitivity_mv_per_a\":"); j+=String(hallSensitivityMvPerA,5);
  j+=F(",\"invert\":"); j+=hallInvert?F("true"):F("false");
  j+=F(",\"input_mv\":"); if(hallOnline&&!isnan(hallInputMv))j+=String(hallInputMv,3);else j+=F("null");
  j+=F(",\"current_a\":"); if(hallOnline&&!isnan(hallCurrentA))j+=String(hallCurrentA,3);else j+=F("null");
  j+=F(",\"age_ms\":"); if(hallUpdatedMs)j+=(millis()-hallUpdatedMs);else j+=F("null"); j+='}'; sendJson(200,j);
}

void handleHallConfigSet() {
  if(!adminAuthorized()){sendJson(401,F("{\"ok\":false,\"error\":\"Admin authorization required\"}"));return;}
  String body=web.arg("plain");
  double en=hallEnabled?1:0,addr=hallAdsAddress,ch=hallChannel,zero=hallZeroMv,sens=hallSensitivityMvPerA,inv=hallInvert?1:0;
  jsonFindNumber(body,"enabled",en); jsonFindNumber(body,"address",addr); jsonFindNumber(body,"channel",ch);
  jsonFindNumber(body,"zero_mv",zero); jsonFindNumber(body,"sensitivity_mv_per_a",sens); jsonFindNumber(body,"invert",inv);
  if(!((int)addr==0 || ((int)addr>=ADS1115_ADDR_FIRST && (int)addr<=ADS1115_ADDR_LAST)) || ch<0 || ch>3 || zero<0 || zero>5500 || sens<0.05 || sens>1000) {
    sendJson(400,F("{\"ok\":false,\"error\":\"Invalid ADS1115/Hall configuration\"}")); return;
  }
  hallEnabled=(en!=0); hallAdsAddress=(uint8_t)addr; hallChannel=(uint8_t)ch; hallZeroMv=(float)zero;
  hallSensitivityMvPerA=(float)sens; hallInvert=(inv!=0); hallResolvedAddress=0; hallLastPollMs=0;
  appPrefs.putBool("hall_en",hallEnabled); appPrefs.putUInt("hall_addr",hallAdsAddress); appPrefs.putUInt("hall_ch",hallChannel);
  appPrefs.putFloat("hall_zero",hallZeroMv); appPrefs.putFloat("hall_sens",hallSensitivityMvPerA); appPrefs.putBool("hall_inv",hallInvert);
  serviceHallCurrent(); sendJson(200,F("{\"ok\":true}"));
}

void handleHallZeroCal() {
  if(!adminAuthorized()){sendJson(401,F("{\"ok\":false,\"error\":\"Admin authorization required\"}"));return;}
  float mv=0; if(!hallAverageMv(mv,10)){sendJson(503,F("{\"ok\":false,\"error\":\"ADS1115 not responding\"}"));return;}
  hallZeroMv=mv; appPrefs.putFloat("hall_zero",hallZeroMv); hallLastPollMs=0; serviceHallCurrent();
  String j=String("{\"ok\":true,\"zero_mv\":")+String(hallZeroMv,3)+"}"; sendJson(200,j);
}

void handleHallSpanCal() {
  if(!adminAuthorized()){sendJson(401,F("{\"ok\":false,\"error\":\"Admin authorization required\"}"));return;}
  String body=web.arg("plain"); double known=0; if(!jsonFindNumber(body,"current_a",known) || fabs(known)<0.5 || fabs(known)>1000) {
    sendJson(400,F("{\"ok\":false,\"error\":\"Known current must be between 0.5 and 1000 A (signed)\"}"));return;
  }
  float mv=0; if(!hallAverageMv(mv,10)){sendJson(503,F("{\"ok\":false,\"error\":\"ADS1115 not responding\"}"));return;}
  float signedK=(mv-hallZeroMv)/(float)known; float sens=fabsf(signedK);
  if(sens<0.05f || sens>1000.0f){sendJson(400,F("{\"ok\":false,\"error\":\"Calibration span is too small or invalid\"}"));return;}
  hallSensitivityMvPerA=sens; hallInvert=(signedK<0.0f); appPrefs.putFloat("hall_sens",hallSensitivityMvPerA); appPrefs.putBool("hall_inv",hallInvert);
  hallLastPollMs=0; serviceHallCurrent();
  String j=String("{\"ok\":true,\"sensitivity_mv_per_a\":")+String(hallSensitivityMvPerA,5)+",\"invert\":"+(hallInvert?"true":"false")+"}"; sendJson(200,j);
}

void handlePzemConfigSet() {
  if(!adminAuthorized()){sendJson(401,F("{\"ok\":false,\"error\":\"Admin authorization required\"}"));return;}
  String body=web.arg("plain"); double a=1,en=1;
  jsonFindNumber(body,"address",a); jsonFindNumber(body,"enabled",en);
  if(a<1 || a>247 || (uint8_t)a==modbusSlave){sendJson(400,F("{\"ok\":false,\"error\":\"PZEM address must be 1..247 and different from inverter\"}"));return;}
  pzemSlave=(uint8_t)a; pzemEnabled=(en!=0); appPrefs.putUInt("pzem_slave",pzemSlave); appPrefs.putBool("pzem_en",pzemEnabled);
  pzemOnline=false; pzemLastPollMs=0;
  sendJson(200,F("{\"ok\":true}"));
}

void handlePzemEnergyReset() {
  if(!adminAuthorized()){sendJson(401,F("{\"ok\":false,\"error\":\"Admin authorization required\"}"));return;}
  String body=web.arg("plain"), confirm;
  if(!jsonFindString(body,"confirm",confirm) || confirm!="RESET_PZEM"){
    sendJson(400,F("{\"ok\":false,\"error\":\"confirm RESET_PZEM required\"}"));return;
  }
  if(!pzemEnabled || pzemSlave==modbusSlave || !rtuJobQueue){sendJson(503,F("{\"ok\":false,\"error\":\"PZEM/RTU unavailable\"}"));return;}
  if(webWriteBusReserved || uxQueueMessagesWaiting(rtuJobQueue)>=5){sendJson(409,F("{\"ok\":false,\"error\":\"RTU is busy\"}"));return;}
  RtuJob job={}; job.type=RTU_JOB_PZEM_RESET; job.id=rtuNextJobId++; if(!job.id)job.id=rtuNextJobId++;
  webWriteBusReserved=true;
  portENTER_CRITICAL(&webWriteResultMux);
  webWriteResult.id=job.id;webWriteResult.done=false;webWriteResult.ok=false;webWriteResult.verified=false;
  webWriteResult.reg=0;webWriteResult.oldRaw=0;webWriteResult.newRaw=0;webWriteResult.error[0]=0;
  portEXIT_CRITICAL(&webWriteResultMux);
  if(xQueueSend(rtuJobQueue,&job,0)!=pdTRUE){webWriteBusReserved=false;sendJson(503,F("{\"ok\":false,\"error\":\"RTU queue full\"}"));return;}
  String j=F("{\"ok\":true,\"queued\":true,\"job_id\":");j+=job.id;j+=F(",\"t1_t2_preserved\":true}");sendJson(202,j);
}

void handlePzemTariffSet() {
  if(!adminAuthorized()){sendJson(401,F("{\"ok\":false,\"error\":\"Admin authorization required\"}"));return;}
  String body=web.arg("plain"); double t1=0,t2=0;
  if(!jsonFindNumber(body,"t1_kwh",t1)||!jsonFindNumber(body,"t2_kwh",t2)||t1<0||t2<0||t1>99999999||t2>99999999){
    sendJson(400,F("{\"ok\":false,\"error\":\"t1_kwh and t2_kwh required\"}"));return;
  }
  pzemTariff.t1_mWh=(uint64_t)llround(t1*1000000.0);
  pzemTariff.t2_mWh=(uint64_t)llround(t2*1000000.0);
  if(pzemOnline && isfinite(pzemEnergyKwh)){pzemTariff.pzemBaseline_Wh=(uint32_t)llround((double)pzemEnergyKwh*1000.0);pzemTariff.baselineValid=1;}
  else pzemTariff.baselineValid=0;
  pzemTariffDirty=true;
  bool saved=pzemTariffSave(true);
  String j=F("{\"ok\":true,\"persisted\":");j+=saved?F("true"):F("false");j+='}';sendJson(200,j);
}

void handleRtcNtpSync() {
  if (!adminAuthorized()) { sendJson(401,F("{\"ok\":false,\"error\":\"Admin authorization required\"}")); return; }
  if (WiFi.status()!=WL_CONNECTED) { sendJson(503,F("{\"ok\":false,\"error\":\"Wi-Fi offline\"}")); return; }
  if (!ntpConfigured) { configTime((long)ntpUtcOffsetMin * 60L, 0, ntpServer.c_str(), NTP_FALLBACK_SERVER); ntpConfigured=true; ntpLastAttemptMs=0; }
  RtcDateTime ndt={0,0,0,0,0,0,false}; uint32_t deadline=millis()+3500;
  while(!ntpLocalDateTime(ndt) && (int32_t)(deadline-millis())>0) { delay(50); feedTaskWatchdog(); }
  if (!ndt.valid) { sendJson(504,F("{\"ok\":false,\"error\":\"NTP time unavailable\"}")); return; }
  RtcDateTime old;
  if(clockNow(old)) ntpLastCorrectionSec=(int32_t)(rtcCivilSeconds(ndt)-rtcCivilSeconds(old)); else ntpLastCorrectionSec=0;
  clockCache(ndt,CLOCK_NTP);
  bool rtcStored=false;
  if(rtcPresent){rtcStored=rtcWrite(ndt);if(!rtcStored)rtcPresent=false;}
  ntpEverSynced=true;ntpLastSyncMs=millis();ntpLastAttemptMs=millis();schedulerLastMinuteKey=0xFFFFFFFFUL;
  String j=F("{\"ok\":true,\"synced\":true,\"source\":\"ntp\",\"rtc_persisted\":");j+=rtcStored?F("true"):F("false");j+='}';sendJson(200,j);
}

void handleScheduleGet() {
  String j; j.reserve(1800); j=F("{\"ok\":true,\"tasks\":[");
  for (uint8_t i=0;i<SCHEDULE_TASK_COUNT;++i) {
    if (i) j+=',';
    const ScheduleTask&t=scheduleTasks[i];
    j+=F("{\"slot\":");j+=i;
    j+=F(",\"enabled\":");j+=t.enabled?F("true"):F("false");
    j+=F(",\"days\":");j+=t.daysMask;
    j+=F(",\"hour\":");j+=t.hour;
    j+=F(",\"minute\":");j+=t.minute;
    j+=F(",\"register\":");j+=t.reg;
    j+=F(",\"raw\":");j+=t.raw;
    j+='}';
  }
  j+=F("]}"); sendJson(200,j);
}

void handleScheduleSet() {
  if (!adminAuthorized()) { sendJson(401,F("{\"ok\":false,\"error\":\"Admin authorization required\"}")); return; }
  String body=web.arg("plain");
  double slotD,daysD,hD,mD,regD,rawD; bool enabled=false;
  if (!jsonFindNumber(body,"slot",slotD)||!jsonFindBool(body,"enabled",enabled)||
      !jsonFindNumber(body,"days",daysD)||!jsonFindNumber(body,"hour",hD)||!jsonFindNumber(body,"minute",mD)||
      !jsonFindNumber(body,"register",regD)||!jsonFindNumber(body,"raw",rawD)) {
    sendJson(400,F("{\"ok\":false,\"error\":\"slot/enabled/days/hour/minute/register/raw required\"}")); return;
  }
  int slot=(int)slotD;
  if (slot<0||slot>=SCHEDULE_TASK_COUNT||daysD<1||daysD>127||hD<0||hD>23||mD<0||mD>59||
      regD<0||regD>65535||rawD<0||rawD>65535) {
    sendJson(400,F("{\"ok\":false,\"error\":\"Invalid scheduler values\"}")); return;
  }
  uint16_t reg=(uint16_t)regD,raw=(uint16_t)rawD;
  String verr;
  if (reg==316 || reg==338 || reg>=400 || reg==344) {
    sendJson(400,F("{\"ok\":false,\"error\":\"This register is blocked in scheduler\"}")); return;
  }
  if (!validateRaw(reg,raw,verr)) {
    String j=F("{\"ok\":false,\"error\":\"");j+=jsonEscape(verr);j+=F("\"}");sendJson(400,j);return;
  }
  scheduleTasks[slot].enabled=enabled;
  scheduleTasks[slot].daysMask=(uint8_t)daysD;
  scheduleTasks[slot].hour=(uint8_t)hD;
  scheduleTasks[slot].minute=(uint8_t)mD;
  scheduleTasks[slot].reg=reg;
  scheduleTasks[slot].raw=raw;
  saveScheduleTask((uint8_t)slot);
  sendJson(200,F("{\"ok\":true,\"saved\":true}"));
}

void appendMaskNamesJson(String& j, uint32_t mask, const char* const* names, uint8_t count) {
  j+='['; bool first=true;
  for(uint8_t bit=0;bit<count;++bit){
    if(!(mask&(1UL<<bit))) continue;
    if(!first) j+=','; first=false;
    j+=F("{\"bit\":"); j+=bit; j+=F(",\"text\":\""); j+=jsonEscape(String(names[bit])); j+=F("\"}");
  }
  j+=']';
}

void handleEvents() {
  String j; j.reserve(6000); j=F("{\"ok\":true,\"events\":[");
  uint8_t count,head;
  portENTER_CRITICAL(&inverterEventMux); count=inverterEventCount; head=inverterEventHead; portEXIT_CRITICAL(&inverterEventMux);
  for(uint8_t n=0;n<count;++n){
    uint8_t idx=(uint8_t)((head+INVERTER_EVENT_CAPACITY-1-n)%INVERTER_EVENT_CAPACITY); InverterEvent e;
    portENTER_CRITICAL(&inverterEventMux); e=inverterEvents[idx]; portEXIT_CRITICAL(&inverterEventMux);
    if(n)j+=','; j+=F("{\"id\":");j+=e.id; j+=F(",\"uptime_s\":");j+=e.uptimeSec;
    j+=F(",\"timestamp\":"); if(e.timestamp[0]){j+='"';j+=e.timestamp;j+='"';}else j+=F("null");
    j+=F(",\"type\":\"");j+=e.type==1?F("fault"):(e.type==2?F("warning"):F("mode"));j+='"';
    j+=F(",\"severity\":\"");j+=e.severity;j+='"'; j+=F(",\"bit\":");if(e.bit==255)j+=F("null");else j+=e.bit;
    j+=F(",\"code\":");j+=e.code; j+=F(",\"active\":");j+=e.active?F("true"):F("false");
    j+=F(",\"message\":\"");j+=jsonEscape(String(e.message));j+=F("\"}");
  }
  j+=F("]}"); sendJson(200,j);
}
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
void loop() {
  loopHeartbeat++;
  feedTaskWatchdog();
  if(otaRestartPending && (int32_t)(millis()-otaRestartAtMs)>=0){ delay(50); ESP.restart(); }
  serviceBootButton();
  serviceWifiWatchdog();
  serviceHallCurrent();
  serviceHeapWatchdog();
  serviceNtpRtcSync();

  if (setupMode) {
    dnsServer.processNextRequest();
  } else if (WiFi.status() != WL_CONNECTED && wifiSsid.length()) {
    static uint32_t lastRetry = 0;
    if ((uint32_t)(millis() - lastRetry) > 10000) {
      lastRetry = millis();
      Serial.println(F("[WiFi] reconnect stored network"));
      WiFi.disconnect();
      WiFi.begin(wifiSsid.c_str(), wifiPass.c_str());
    }
  }

  web.handleClient();
  if(!otaInProgress && !otaRestartPending) serviceRtuWatchdog();

  // RTU polling is owned by the dedicated worker; loop() never waits for Modbus.

  if(!otaInProgress && !otaRestartPending){
    serviceScheduler();
    serviceBatteryStats();
    servicePzemTariff();
  }

  feedTaskWatchdog();
  delay(1);
}
