DanilVDV/esp32-anenji-wifi-rs485-controller/(commit log)

2026-10-07 Make alert HTML insertion tolerant
2026-10-07 Handle current UI anchors in artifact build
2026-10-07 Add datalogger service stability patcher
    [apply_datalogger_v0_15_2.py]
2026-10-07 Fix datalogger stability patch anchors
    [apply_datalogger_v0_15_2.py]
2026-10-07 Stabilize datalogger service Wi-Fi and watchdog behavior
    [ANENJI_ESP32_Controller.ino]
2026-10-08 Add power flow tab patcher for v0.15.4
2026-10-08 Promote power flow tab v0.15.4 to main
2026-10-08 Add dedicated EyeBond-style power flow tab
2026-10-08 Fix scheduler tab card routing
    [ANENJI_ESP32_Controller.ino]
2026-10-08 Add current battery UI screenshot payload
2026-10-08 Refresh current Web UI screenshots
2026-10-08 Add workflow to regenerate readable current README media
2026-10-08 Stage README screenshot part 1
2026-10-08 Stage README screenshot part 2
2026-10-08 Stage README screenshot part 3
2026-10-08 Stage README screenshot part 4
2026-10-08 Stage README screenshot part 5
2026-10-08 Stage README screenshot part 6
2026-10-08 Stage README screenshot part 7
2026-10-08 Add README current screenshot helper
2026-10-08 Use current real Web UI screenshot
2026-10-08 Add v0.15.9 Hall sensor patch tool
2026-10-08 Document PZCT-DC63 ADS1115 wiring
2026-10-08 Add v0.15.9 Hall sensor promotion workflow
2026-10-08 Add PZCT-DC63 current sensor via ADS1115
2026-10-08 Document ESP32 board pin labels and 3.3V wiring
2026-10-08 Trigger ESP32 pin label documentation update
2026-10-08 Apply board labels and 3.3V documentation
2026-10-08 Clarify ESP32 board labels and 3.3V wiring
2026-10-08 Document 3.3V Hall sensor wiring
2026-10-08 Add ESP32 pin label diagram
2026-10-08 Document ESP32 board labels and 3.3V module wiring
2026-10-08 Remove temporary pin label updater
2026-10-14 Pin CI runner and update checkout action
2026-10-14 Pin release runner and update checkout action
2026-10-14 Document ADS1115 5V supply
2026-10-14 Correct ADS1115 wiring to 5V
2026-10-14 Add one-shot README ADS1115 5V correction
2026-10-14 Correct ADS1115 5V wiring documentation
2026-10-14 Document PZCT-DC63-300A 5V sensor data
2026-10-14 Document PZCT-DC63-300A 5V wiring
